nbolton/greenhouse/hardware/greenhouse-control-unit/prototype-photos/battery sensor bottom.jpg

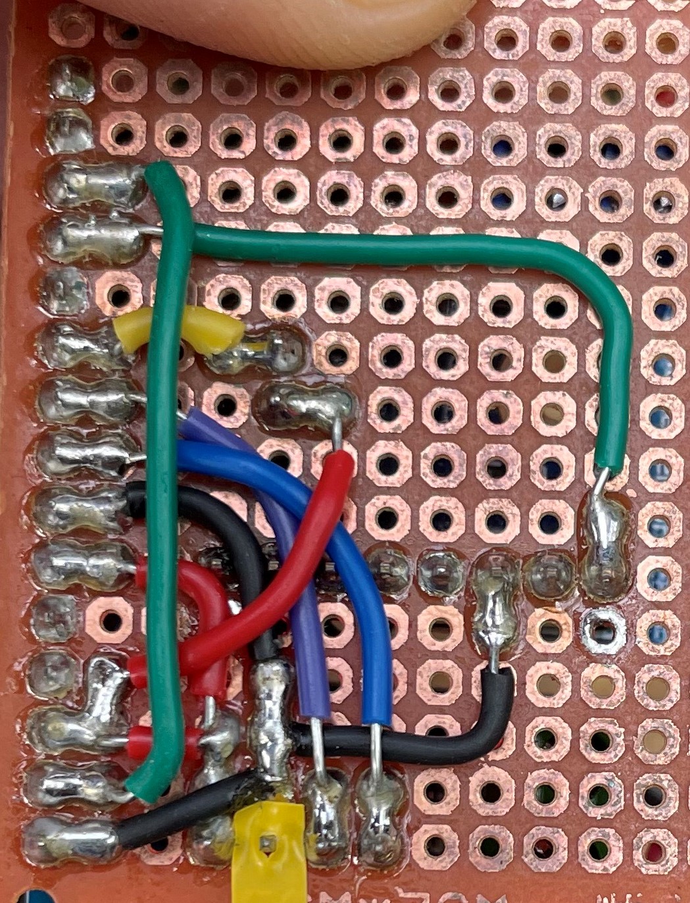
hardware/greenhouse-control-unit/prototype-photos/battery sensor bottom.jpg
