nbolton/greenhouse/hardware/greenhouse-control-unit/prototype-photos/control unit bottom.jpg

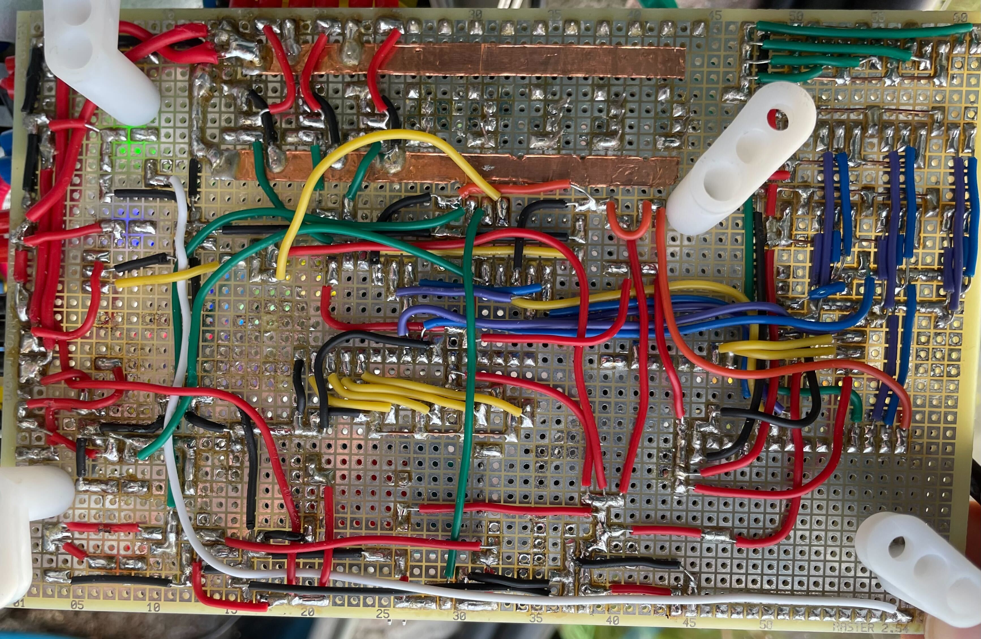
hardware/greenhouse-control-unit/prototype-photos/control unit bottom.jpg
