nbolton/greenhouse/README.md

# Greenhouse
## An attempt to automate nature 🌶

### Prerequesits
- VSCode with Platform.io extension
- MinGW if Windows
  - [Chocolatey](https://chocolatey.org/): `choco install mingw`
  - Alternative: [MinGW](https://sourceforge.net/projects/mingwbuilds/files/latest/download)
