nbolton/greenhouse/hardware/greenhouse-control-unit/prototype-photos/battery sensor top.jpg

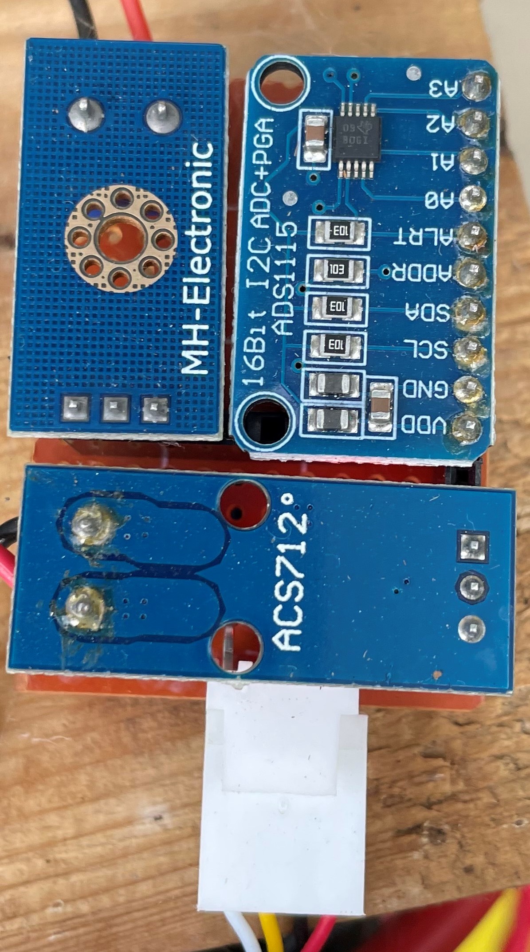
hardware/greenhouse-control-unit/prototype-photos/battery sensor top.jpg
