nbolton/greenhouse/hardware/greenhouse-control-unit/prototype-photos/battery.jpg

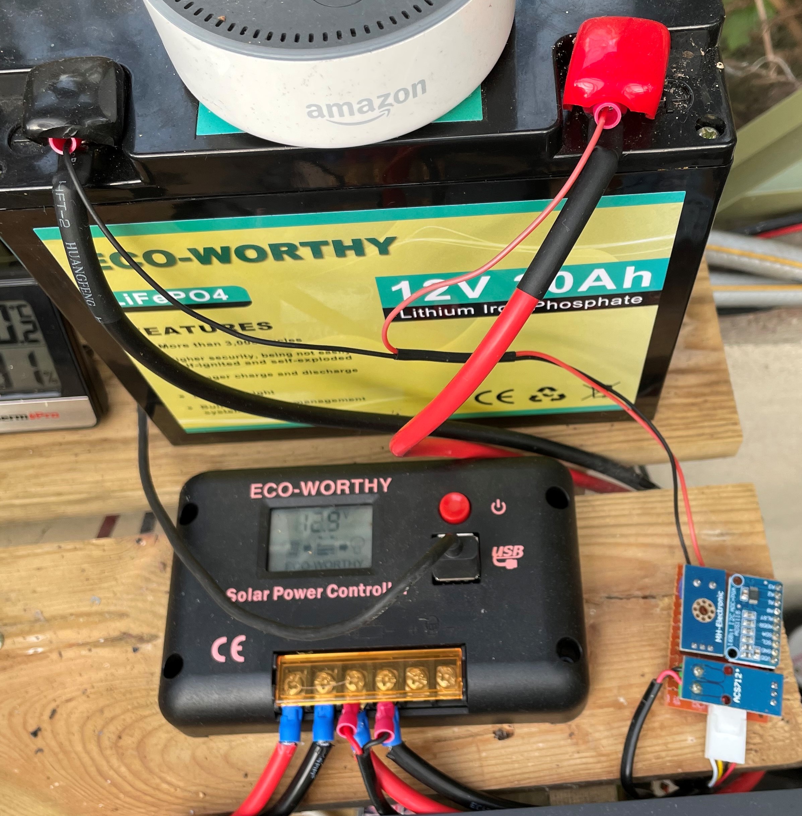
hardware/greenhouse-control-unit/prototype-photos/battery.jpg
