nbolton/greenhouse/hardware/greenhouse-control-unit/prototype-photos/control unit top.jpg

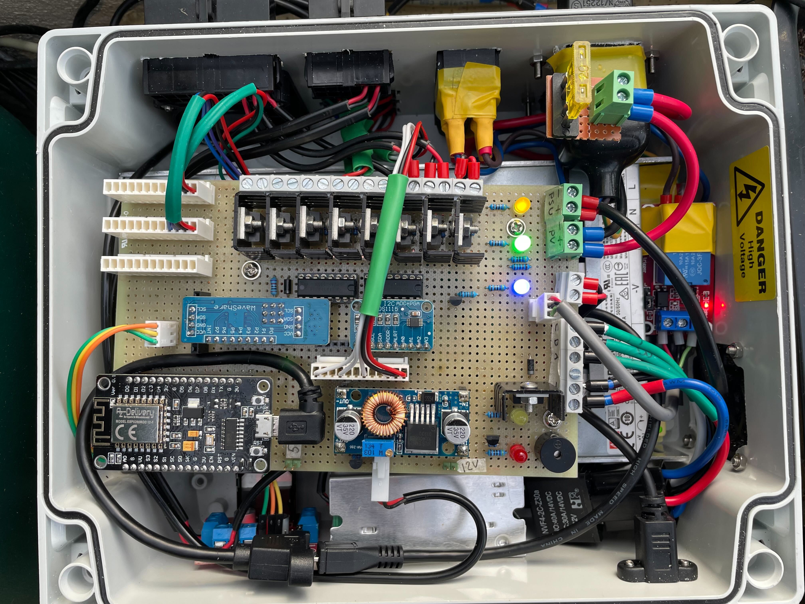
hardware/greenhouse-control-unit/prototype-photos/control unit top.jpg
