nbolton/greenhouse/hardware/greenhouse-control-unit/greenhouse-control-unit.kicad_pcb

## KiCad design hardware/greenhouse-control-unit/greenhouse-control-unit.kicad_pcb (2023-05-08)

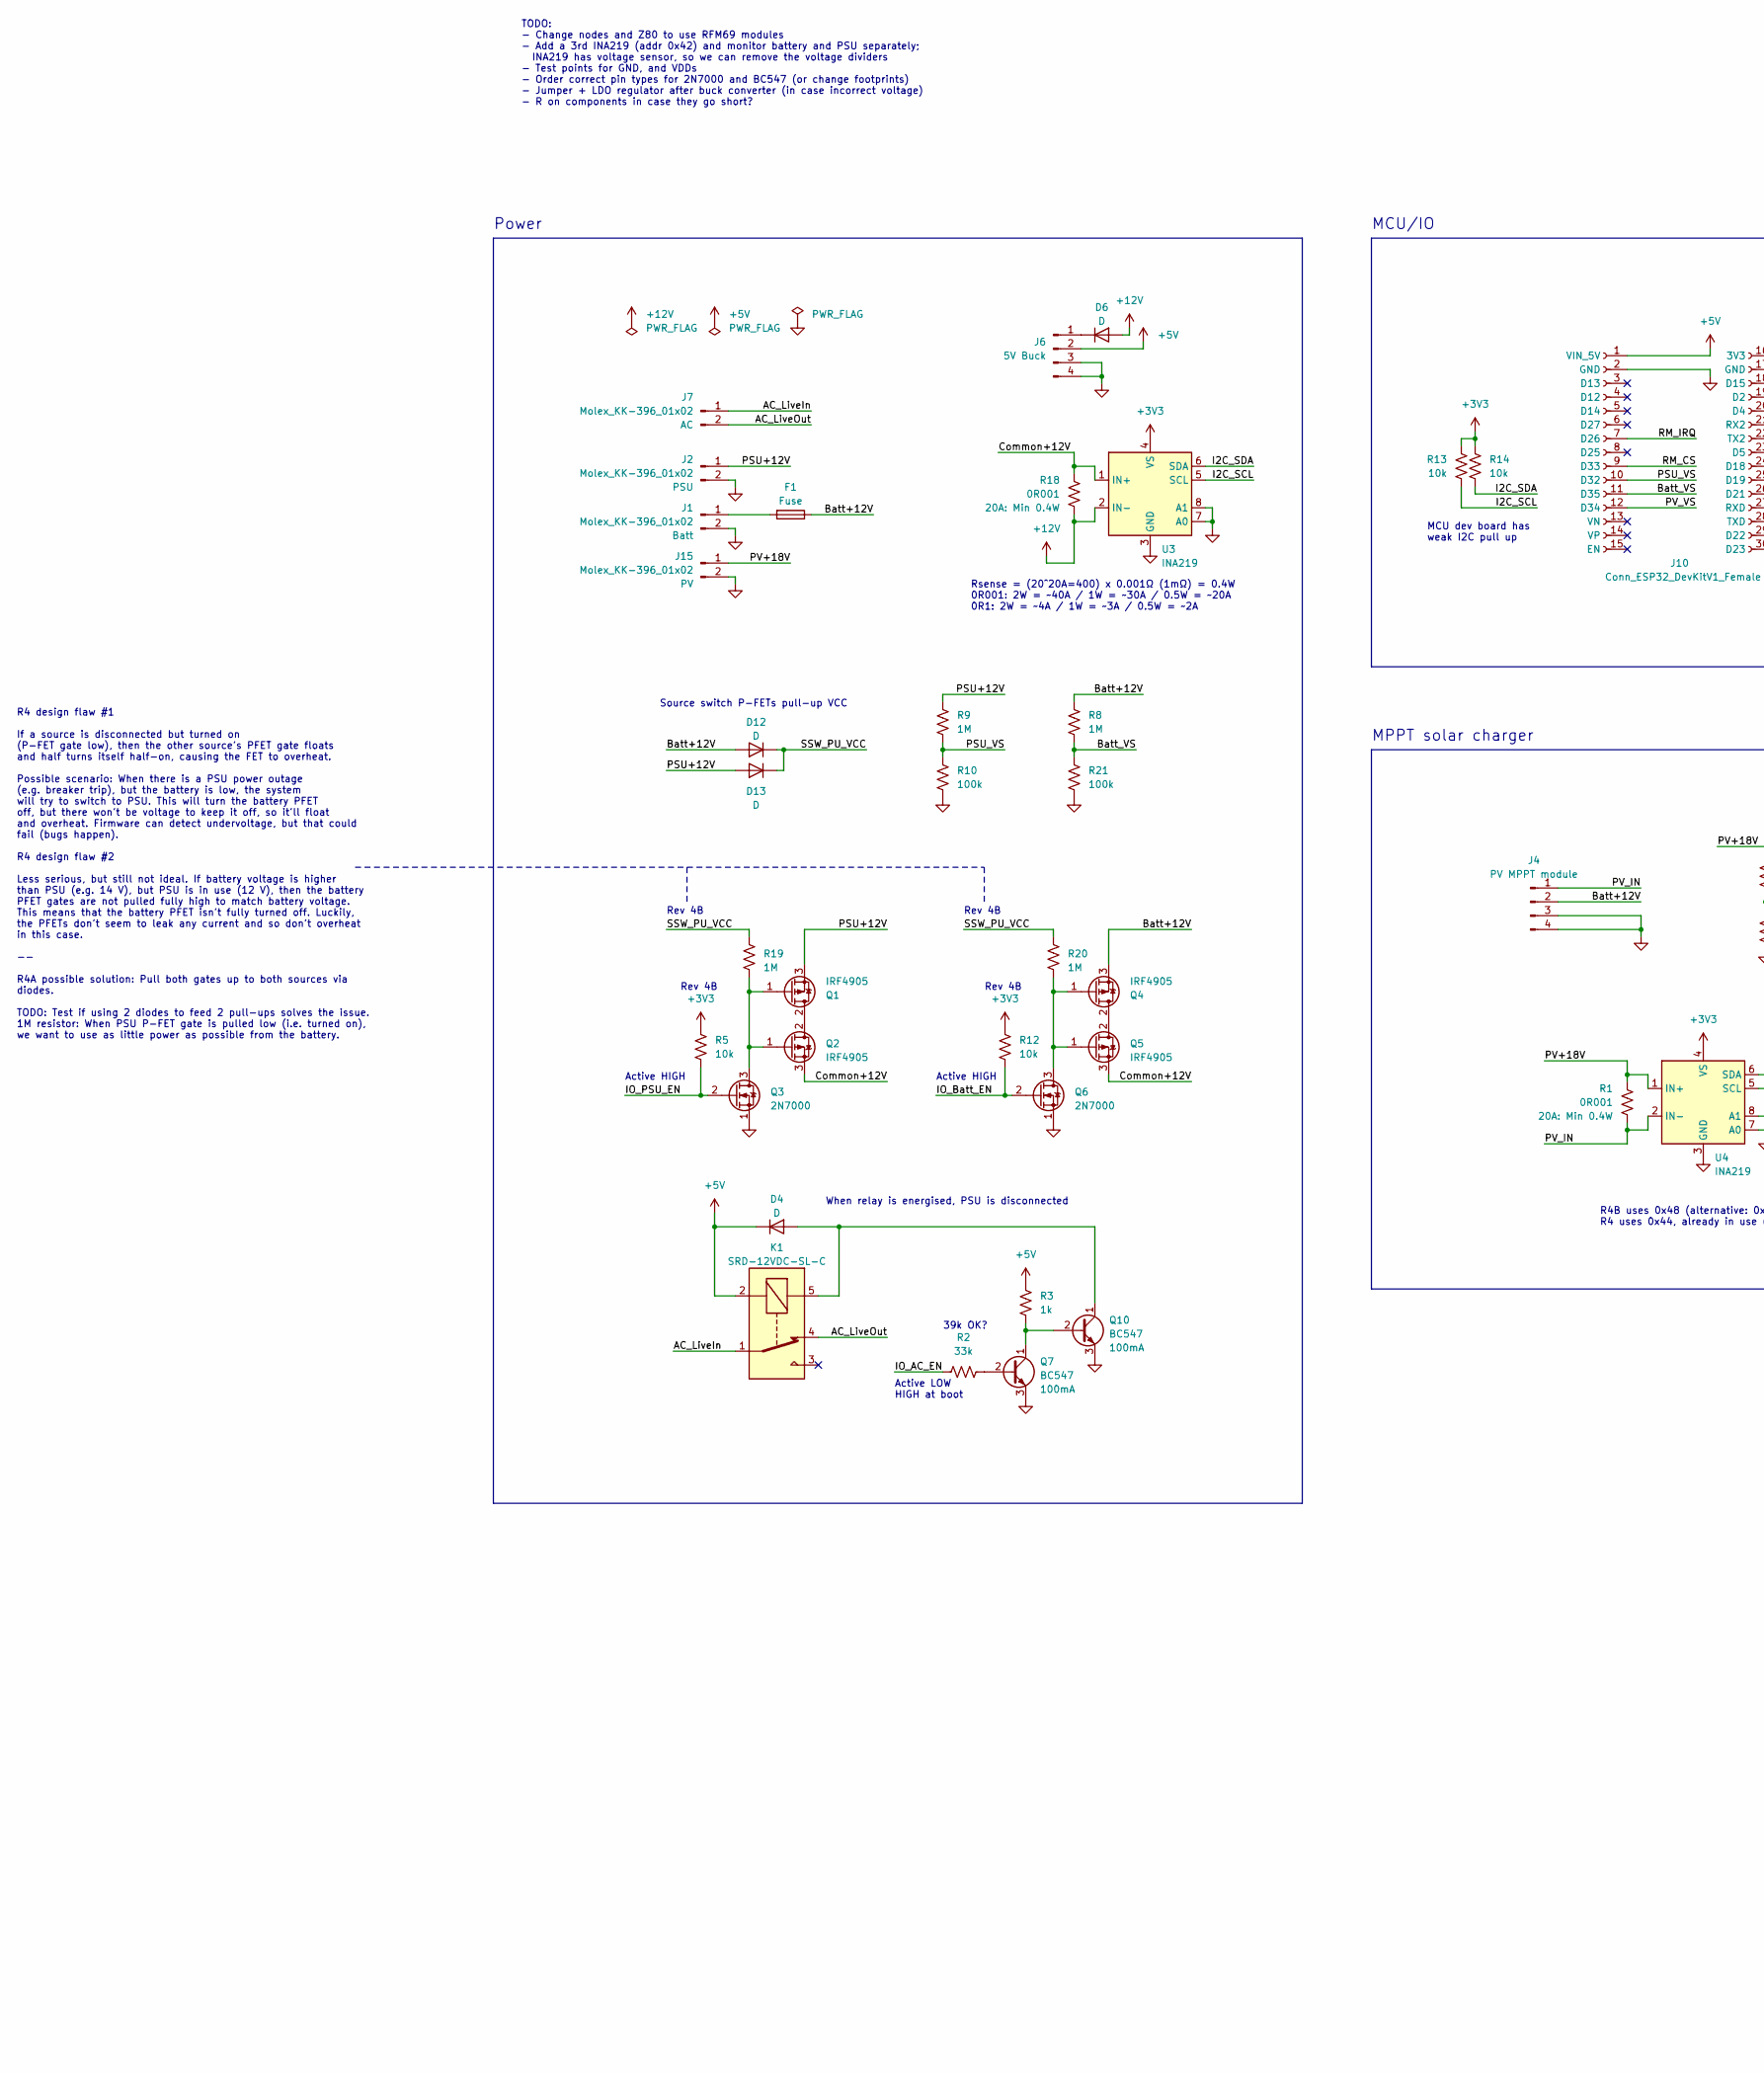
[picture p6: schematic greenhouse-control-unit.kicad_sch, Greenhouse Control Unit, part in row 1, column 1]

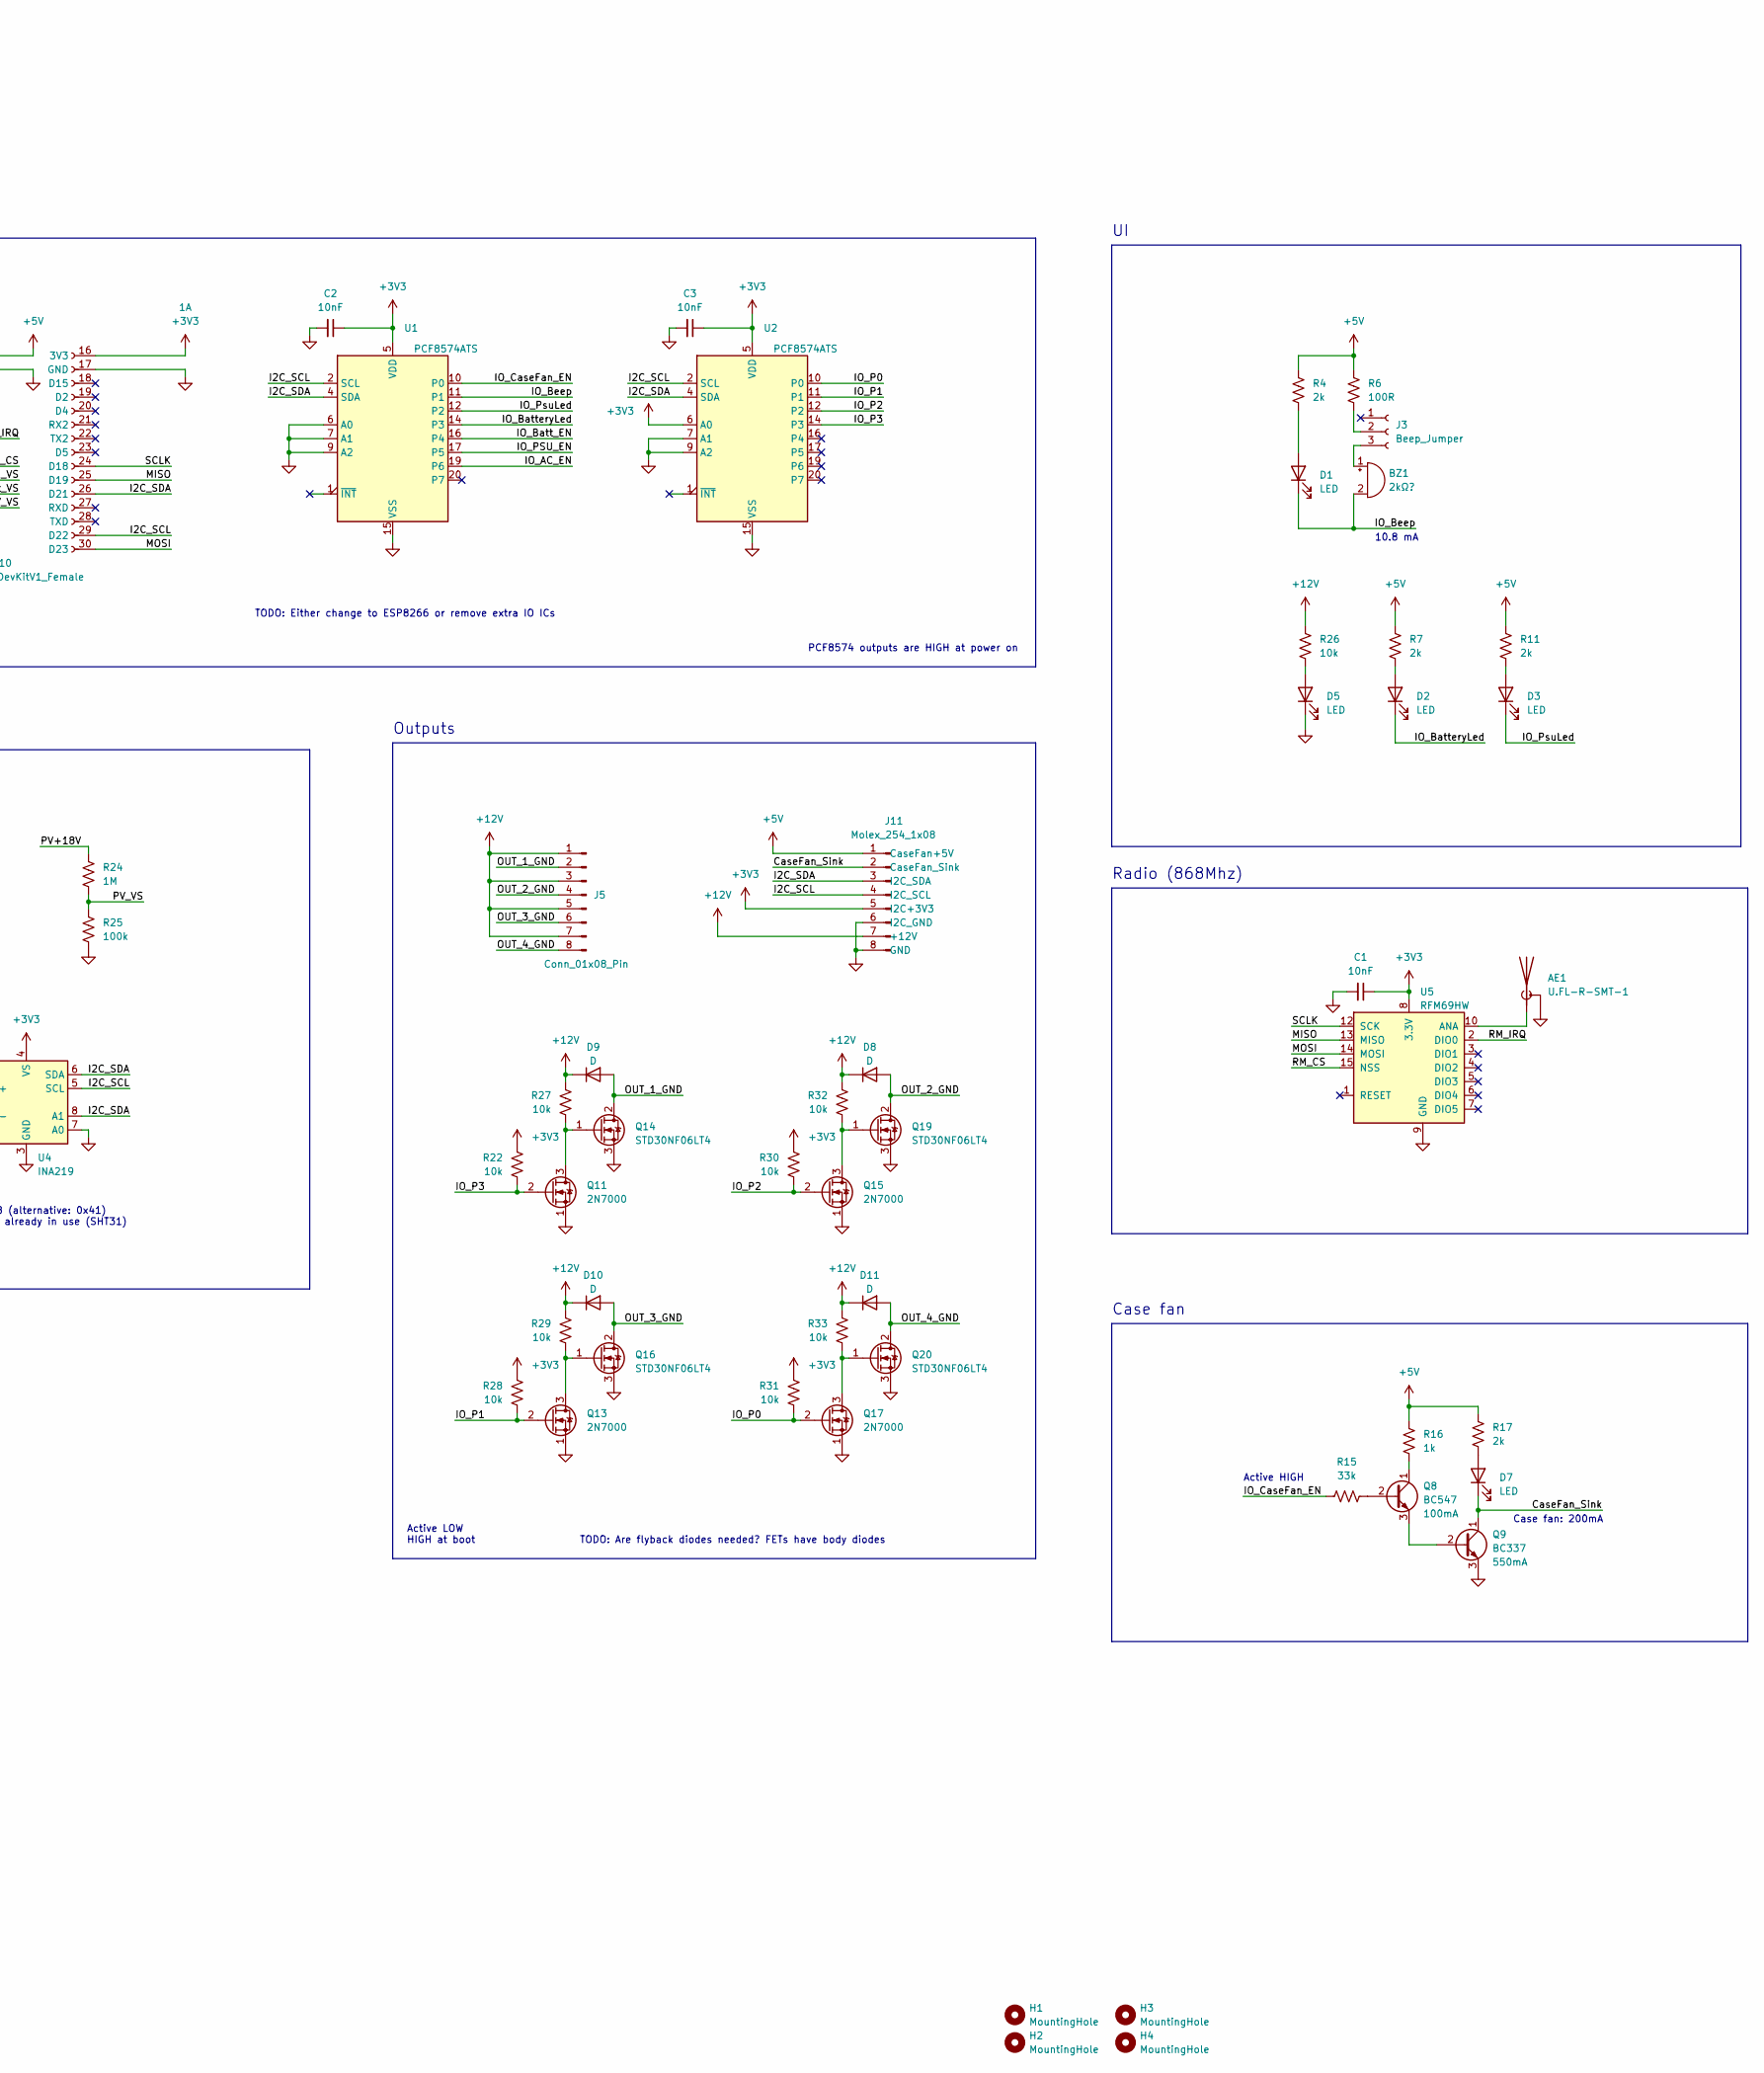
[picture p7: schematic greenhouse-control-unit.kicad_sch, Greenhouse Control Unit, part in row 1, column 2]

Parts:
AE1: U.FL-R-SMT-1; U.FL_Hirose_U.FL-R-SMT-1_Vertical
BZ1: 2kΩ?; Buzzer_12x9.5RM7.6
C1, C2, C3: 10nF; C_Disc_D3.0mm_W2.0mm_P2.50mm
D1, D2, D3, D5, D7: LED; LED_D5.0mm
D4, D12, D13: D; D_DO-35_SOD27_P7.62mm_Horizontal
D6: D; D_DO-41_SOD81_P7.62mm_Horizontal
D8, D9, D10, D11: D; D_DO-41_SOD81_P2.54mm_Vertical_AnodeUp
F1: Fuse; Fuse_3522-2_L
H1, H2, H3, H4: MountingHole; MountingHole_3mm
J1, J2, J7, J15: Molex_KK-396_01x02; Molex_KK-396_1x02_P3.96mm_Vertical
J3: Beep_Jumper; PinHeader_1x03_P2.54mm_Vertical
J4: PV MPPT module; MPPT-10A-Module
J5: Conn_01x08_Pin; Molex_KK-396_1x08_P3.96mm_Vertical
J6: 5V Buck; Buck_Module
J10: Conn_ESP32_DevKitV1_Female; PinSocket_ESP32_DevKitV1
J11: Molex_254_1x08; Molex_KK-254_AE-6410-08A_1x08_P2.54mm_Vertical
K1: SRD-12VDC-SL-C; Relay_SRD-12VDC-SL-C
Q1, Q2, Q4, Q5: IRF4905; TO-220-3_Vertical
Q3, Q6, Q11, Q13, Q15, Q17: 2N7000; TO-92_Inline
Q7, Q8, Q10: BC547; TO-92_Inline
Q9: BC337; TO-92_Inline
Q14, Q16, Q19, Q20: STD30NF06LT4; TO-252-2
R1, R18: 0R001; R_2512_6332Metric_Pad1.40x3.35mm_HandSolder
R2, R15: 33k; R_Axial_DIN0207_L6.3mm_D2.5mm_P7.62mm_Horizontal
R3, R16: 1k; R_Axial_DIN0207_L6.3mm_D2.5mm_P7.62mm_Horizontal
R4, R7, R11, R17: 2k; R_Axial_DIN0207_L6.3mm_D2.5mm_P7.62mm_Horizontal
R5, R12, R22, R26, R27, R28, R29, R30, R31, R32, R33: 10k; R_Axial_DIN0207_L6.3mm_D2.5mm_P7.62mm_Horizontal
R6: 100R; R_Axial_DIN0207_L6.3mm_D2.5mm_P7.62mm_Horizontal
R8, R9, R19, R20, R24: 1M; R_Axial_DIN0207_L6.3mm_D2.5mm_P7.62mm_Horizontal
R10, R21, R25: 100k; R_Axial_DIN0207_L6.3mm_D2.5mm_P7.62mm_Horizontal
R13, R14: 10k; R_Axial_DIN0204_L3.6mm_D1.6mm_P5.08mm_Horizontal
U1, U2: PCF8574ATS; SSOP-20_4.4x6.5mm_P0.65mm
U3, U4: INA219; SOT-23-8
U5: RFM69HW; HopeRF_RFM69HW

Connections:
+3V3: C1.1, C2.1, C3.1, J10.16 (3V3), J11.5 (I2C+3V3), R5.2, R12.2, R13.1, R14.1, R22.1, R28.1, R30.1, R31.1, U1.5 (VDD), U2.5 (VDD), U2.6 (A0), U3.4 (VS), U4.4 (VS), U5.8 (3.3V)
+5V: D4.1 (K), J6.2, J10.1 (VIN_5V), J11.1 (CaseFan+5V), K1.2, R3.2, R4.1, R6.1, R7.1, R11.1, R16.2, R17.1
+12V: D6.2 (A), D8.1 (K), D9.1 (K), D10.1 (K), D11.1 (K), J5.1, J5.3, J5.5, J5.7, J11.7 (+12V), R18.1, R26.1, R27.1, R29.1, R32.1, R33.1, U3.2 (IN-)
/AC_LiveIn: J7.1, K1.1
/AC_LiveOut: J7.2, K1.4
/Batt+12V: D12.2 (A), F1.1, J4.2, Q4.3 (S), R8.1
/Batt_VS: J10.11 (D35), R8.2, R21.1
/CaseFan_Sink: D7.1 (K), J11.2 (CaseFan_Sink), Q9.1 (C)
/Common+12V: Q2.3 (S), Q5.3 (S), R18.2, U3.1 (IN+)
/I2C_SCL: J10.29 (D22), J11.4 (I2C_SCL), R13.2, U1.2 (SCL), U2.2 (SCL), U3.5 (SCL), U4.5 (SCL)
/I2C_SDA: J10.26 (D21), J11.3 (I2C_SDA), R14.2, U1.4 (SDA), U2.4 (SDA), U3.6 (SDA), U4.6 (SDA), U4.8 (A1)
/IO_AC_EN: R2.1, U1.19 (P6)
/IO_Batt_EN: Q6.2 (G), R12.1, U1.16 (P4)
/IO_BatteryLed: D2.1 (K), U1.14 (P3)
/IO_Beep: BZ1.2 (+), D1.1 (K), U1.11 (P1)
/IO_CaseFan_EN: R15.1, U1.10 (P0)
/IO_P0: Q17.2 (G), R31.2, U2.10 (P0)
/IO_P1: Q13.2 (G), R28.2, U2.11 (P1)
/IO_P2: Q15.2 (G), R30.2, U2.12 (P2)
/IO_P3: Q11.2 (G), R22.2, U2.14 (P3)
/IO_PSU_EN: Q3.2 (G), R5.1, U1.17 (P5)
/IO_PsuLed: D3.1 (K), U1.12 (P2)
/MISO: J10.25 (D19), U5.13 (MISO)
/MOSI: J10.30 (D23), U5.14 (MOSI)
/OUT_1_GND: D9.2 (A), J5.2, Q14.2 (D)
/OUT_2_GND: D8.2 (A), J5.4, Q19.2 (D)
/OUT_3_GND: D10.2 (A), J5.6, Q16.2 (D)
/OUT_4_GND: D11.2 (A), J5.8, Q20.2 (D)
/PSU+12V: D13.2 (A), J2.1, Q1.3 (S), R9.1
/PSU_VS: J10.10 (D32), R9.2, R10.1
/PV+18V: J15.1, R1.2, R24.1, U4.1 (IN+)
/PV_IN: J4.1, R1.1, U4.2 (IN-)
/PV_VS: J10.12 (D34), R24.2, R25.1
/RM_CS: J10.9 (D33), U5.15 (NSS)
/RM_IRQ: J10.7 (D26), U5.2 (DIO0)
/SCLK: J10.24 (D18), U5.12 (SCK)
/SSW_PU_VCC: D12.1 (K), D13.1 (K), R19.2, R20.2
GND: AE1.2 (Shield), C1.2, C2.2, C3.2, D5.1 (K), J1.2, J2.2, J4.3, J4.4, J6.3, J6.4, J10.2 (GND), J10.17 (GND), J11.6 (I2C_GND), J11.8 (GND), J15.2, Q3.1 (S), Q6.1 (S), Q7.3 (E), Q9.3 (E), Q10.3 (E), Q11.1 (S), Q13.1 (S), Q14.3 (S), Q15.1 (S), Q16.3 (S), Q17.1 (S), Q19.3 (S), Q20.3 (S), R10.2, R21.2, R25.2, U1.6 (A0), U1.7 (A1), U1.9 (A2), U1.15 (VSS), U2.7 (A1), U2.9 (A2), U2.15 (VSS), U3.3 (GND), U3.7 (A0), U3.8 (A1), U4.3 (GND), U4.7 (A0), U5.9 (GND), U5.11 (GND)
unnamed: AE1.1 (A), U5.10 (ANA)
unnamed: BZ1.1 (-), J3.3
unnamed: D1.2 (A), R4.2
unnamed: D2.2 (A), R7.2
unnamed: D3.2 (A), R11.2
unnamed: D4.2 (A), K1.5, Q10.1 (C)
unnamed: D5.2 (A), R26.2
unnamed: D6.1 (K), J6.1
unnamed: D7.2 (A), R17.2
unnamed: F1.2, J1.1
unnamed: J3.2, R6.2
unnamed: Q1.2 (D), Q2.2 (D)
unnamed: Q1.1 (G), Q2.1 (G), Q3.3 (D), R19.1
unnamed: Q4.2 (D), Q5.2 (D)
unnamed: Q4.1 (G), Q5.1 (G), Q6.3 (D), R20.1
unnamed: Q7.2 (B), R2.2
unnamed: Q8.2 (B), R15.2
unnamed: Q8.1 (C), R16.1
unnamed: Q8.3 (E), Q9.2 (B)
unnamed: Q7.1 (C), Q10.2 (B), R3.1
unnamed: Q11.3 (D), Q14.1 (G), R27.2
unnamed: Q13.3 (D), Q16.1 (G), R29.2
unnamed: Q15.3 (D), Q19.1 (G), R32.2
unnamed: Q17.3 (D), Q20.1 (G), R33.2

Notes on the sheet:
Source switch P-FETs pull-up VCC
When relay is energised, PSU is disconnected
R4B uses 0x48 (alternative: 0x41) R4 uses 0x44, already in use (SHT31)
Rsense = (20^20A=400) x 0.001Ω (1mΩ) = 0.4W 0R001: 2W = ~40A / 1W = ~30A / 0.5W = ~20A 0R1: 2W = ~4A / 1W = ~3A / 0.5W = ~2A
R4 design flaw #1 If a source is disconnected but turned on (P-FET gate low), then the other source's PFET gate floats and half turns itself half-on, causing the FET to overheat. Possible scenario: When there is a PSU power outage (e.g. breaker trip), but the battery is low, the system will try to 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
TODO: - Change nodes and Z80 to use RFM69 modules - Add a 3rd INA219 (addr 0x42) and monitor battery and PSU separately; INA219 has voltage sensor, so we can remove the voltage dividers - Test points for GND, and VDDs - Order correct pin types for 2N7000 and BC547 (or change footprints) - Jumper + 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
Rev 4B
MCU/IO
TODO: Either change to ESP8266 or remove extra IO ICs
Active HIGH
Active LOW HIGH at boot
Case fan: 200mA
Power
Radio (868Mhz)
Outputs
10.8 mA
MCU dev board has weak I2C pull up
TODO: Are flyback diodes needed? FETs have body diodes
PCF8574 outputs are HIGH at power on
39k OK?
Case fan
MPPT solar charger

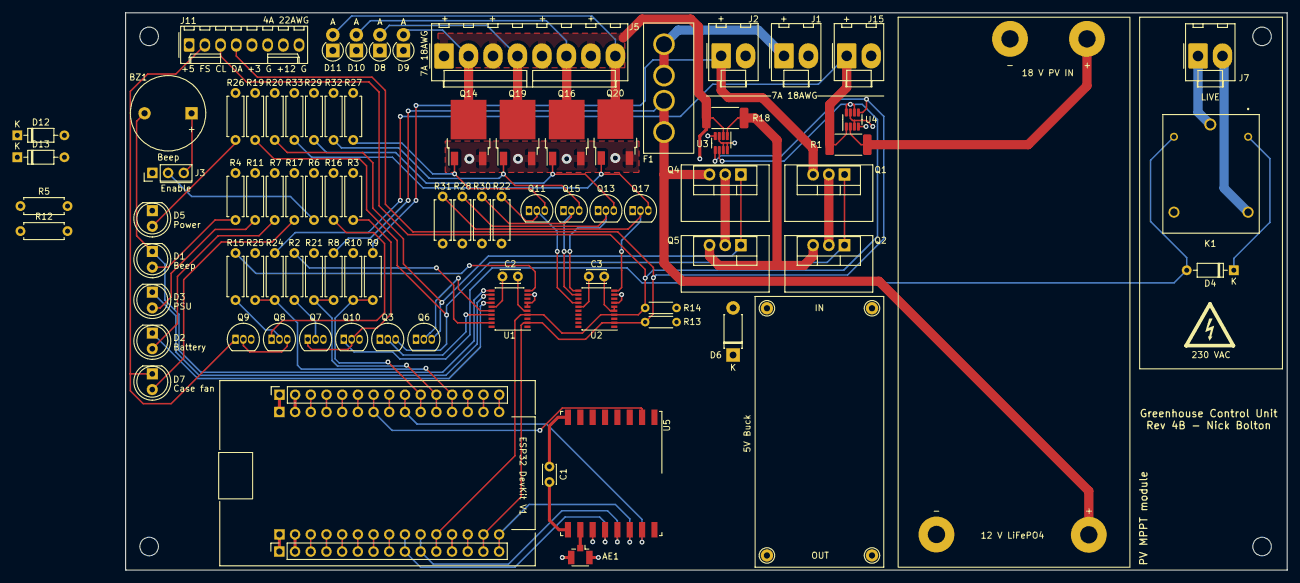
[picture p8: board greenhouse-control-unit.kicad_pcb from above]

Board: 4 copper layers, 188.0 x 90.2 mm, 89 parts (0 on the bottom side), 62 nets.
