nbolton/greenhouse/hardware/greenhouse-node-ts/greenhouse-node-ts.kicad_pcb

## KiCad design hardware/greenhouse-node-ts/greenhouse-node-ts.kicad_pcb (2023-04-27)

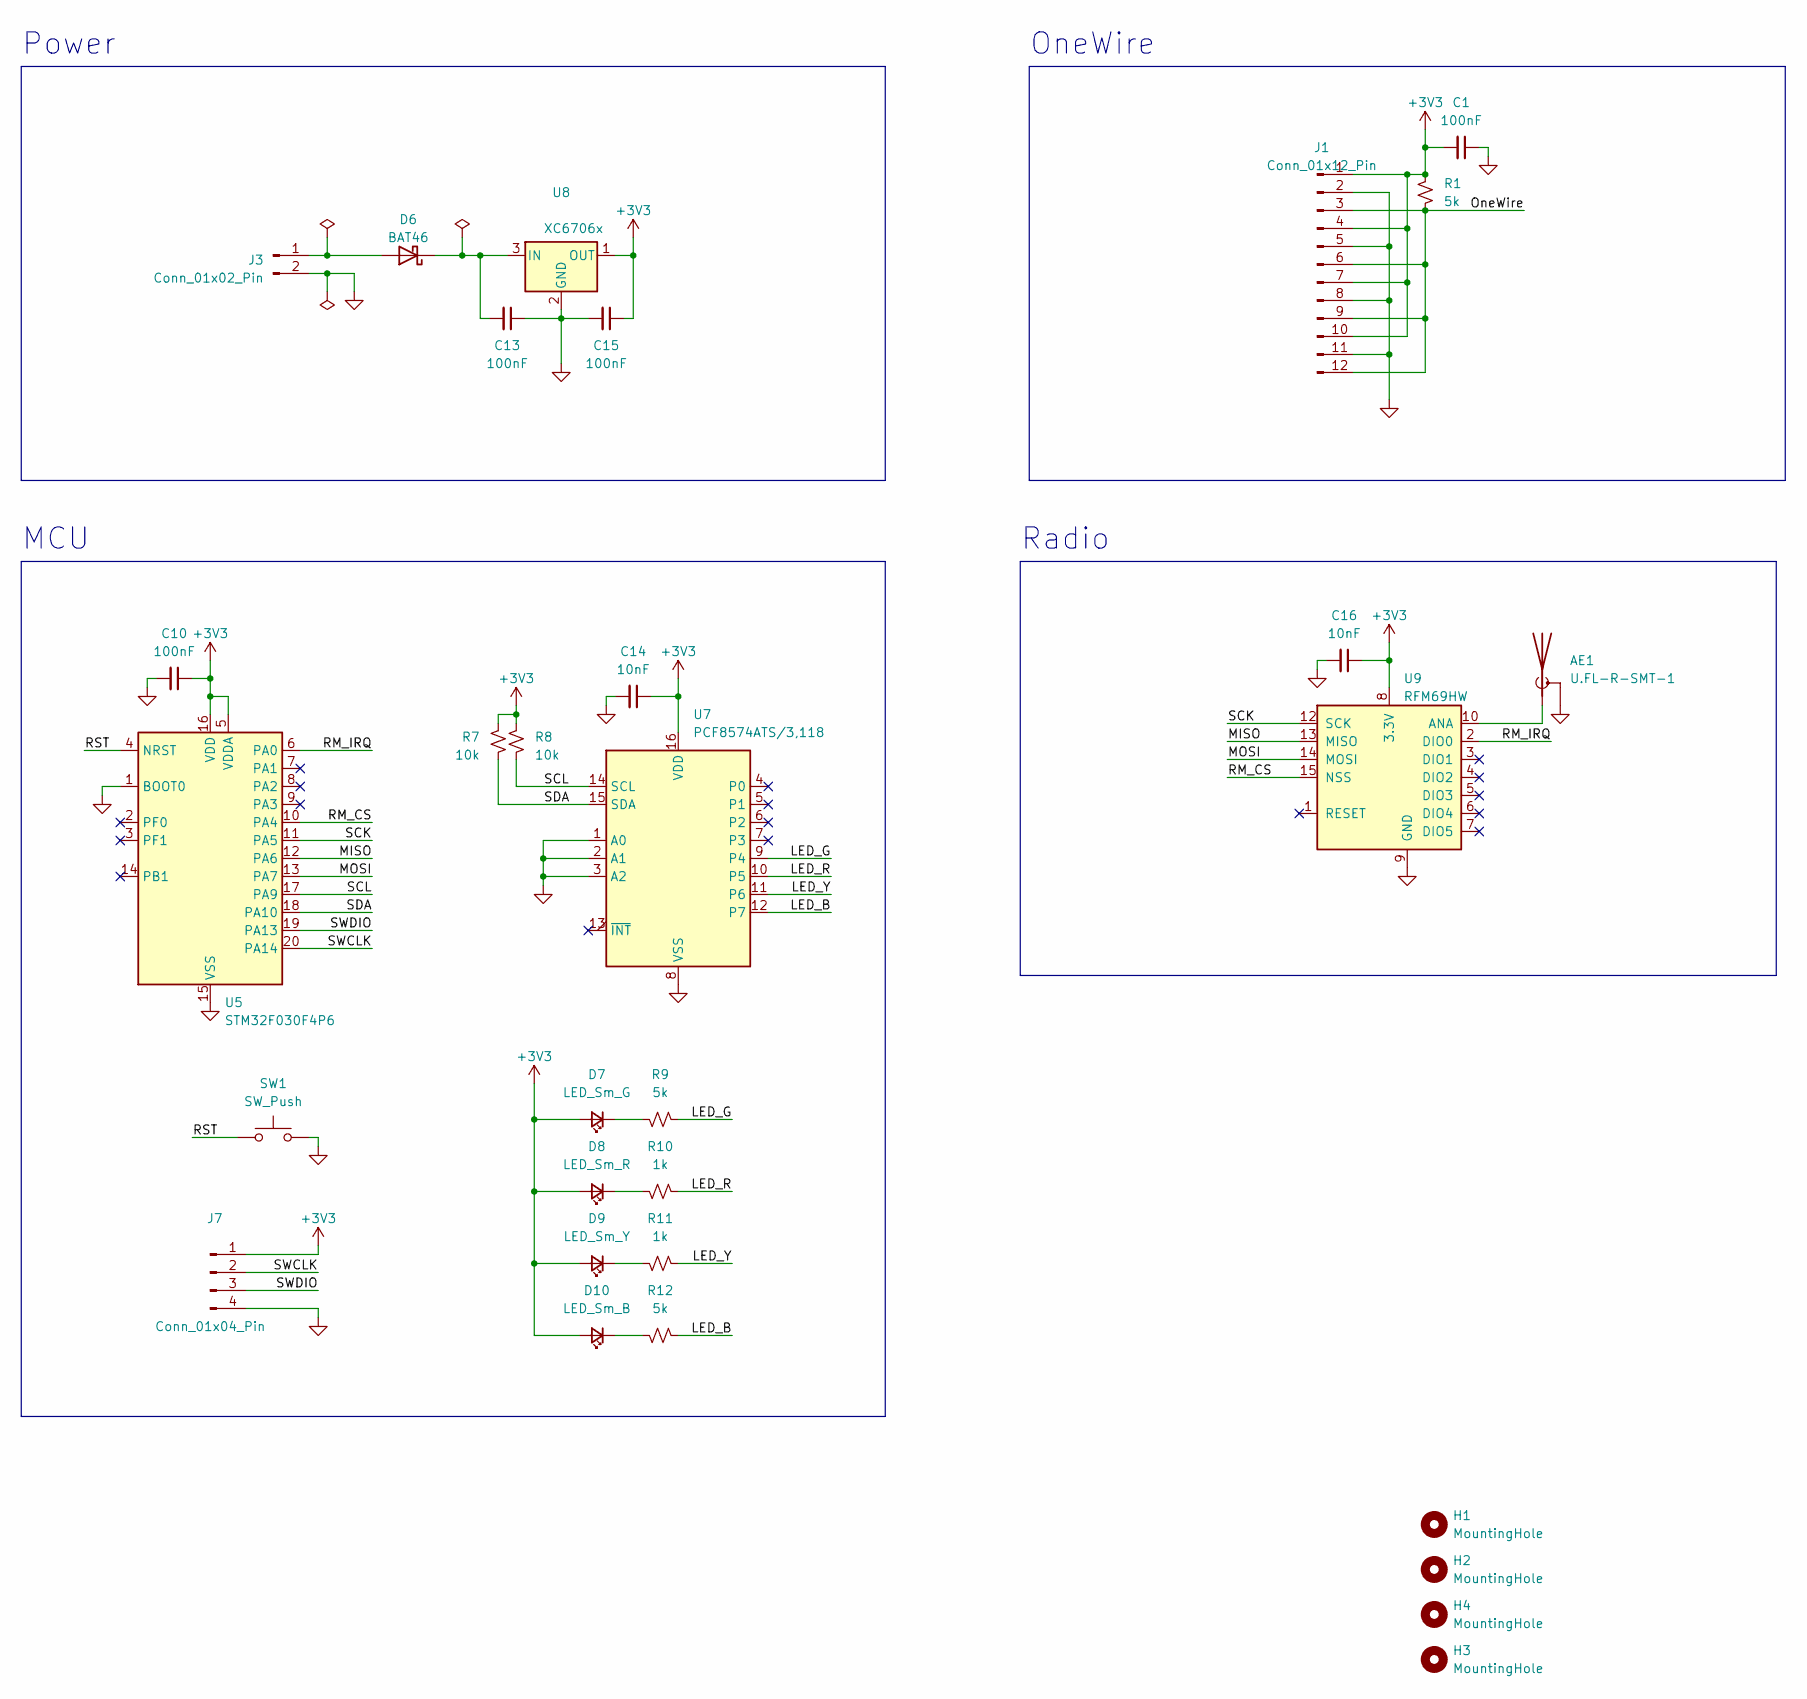
[picture p9: schematic greenhouse-node-ts.kicad_sch, Greenhouse Node (TS)]

Parts:
AE1: U.FL-R-SMT-1; U.FL_Hirose_U.FL-R-SMT-1_Vertical
C1, C10, C13, C15: 100nF; C_Disc_D4.7mm_W2.5mm_P5.00mm
C14, C16: 10nF; C_Disc_D3.0mm_W2.0mm_P2.50mm
D6: BAT46; D_DO-35_SOD27_P7.62mm_Horizontal
D7: LED_Sm_G; LED_D3.0mm
D8: LED_Sm_R; LED_D3.0mm
D9: LED_Sm_Y; LED_D3.0mm
D10: LED_Sm_B; LED_D3.0mm
H1, H2, H3, H4: MountingHole; MountingHole_3.2mm_M3
J1: Conn_01x12_Pin
J3: Conn_01x02_Pin; Molex_KK-254_AE-6410-02A_1x02_P2.54mm_Vertical
J7: Conn_01x04_Pin; JST_PH_B4B-PH-K_1x04_P2.00mm_Vertical
R1, R9, R12: 5k; R_Axial_DIN0207_L6.3mm_D2.5mm_P7.62mm_Horizontal
R7, R8: 10k; R_Axial_DIN0207_L6.3mm_D2.5mm_P7.62mm_Horizontal
R10, R11: 1k; R_Axial_DIN0207_L6.3mm_D2.5mm_P7.62mm_Horizontal
SW1: SW_Push; SW_PUSH_6mm
U5: STM32F030F4P6; TSSOP-20_4.4x6.5mm_P0.65mm
U7: PCF8574ATS/3,118; SSOP-20_4.4x6.5mm_P0.65mm
U8: XC6706x; SOT-89-3
U9: RFM69HW; HopeRF_RFM69HW

Connections:
+3V3: C1.2, C10.1, C14.1, C15.1, C16.1, D7.2 (A), D8.2 (A), D9.2 (A), D10.2 (A), J1.1, J1.4, J1.7, J1.10, J7.1, R1.1, R7.1, R8.1, U5.5 (VDDA), U5.16 (VDD), U7.16 (VDD), U8.1 (OUT), U9.8 (3.3V)
/LED_B: R12.1, U7.12 (P7)
/LED_G: R9.1, U7.9 (P4)
/LED_R: R10.1, U7.10 (P5)
/LED_Y: R11.1, U7.11 (P6)
/MISO: U5.12 (PA6), U9.13 (MISO)
/MOSI: U5.13 (PA7), U9.14 (MOSI)
/OneWire: J1.3, J1.6, J1.9, J1.12, R1.2
/RM_CS: U5.10 (PA4), U9.15 (NSS)
/RM_IRQ: U5.6 (PA0), U9.2 (DIO0)
/RST: SW1.1, U5.4 (NRST)
/SCK: U5.11 (PA5), U9.12 (SCK)
/SCL: R8.2, U5.17 (PA9), U7.14 (SCL)
/SDA: R7.2, U5.18 (PA10), U7.15 (SDA)
/SWCLK: J7.2, U5.20 (PA14)
/SWDIO: J7.3, U5.19 (PA13)
GND: AE1.2 (Shield), C1.1, C10.2, C13.1, C14.2, C15.2, C16.2, J1.2, J1.5, J1.8, J1.11, J3.2, J7.4, SW1.2, U5.1 (BOOT0), U5.15 (VSS), U7.1 (A0), U7.2 (A1), U7.3 (A2), U7.8 (VSS), U8.2 (GND), U9.9 (GND), U9.11 (GND)
unnamed: D6.2 (A), J3.1
unnamed: C13.2, D6.1 (K), U8.3 (IN)
unnamed: AE1.1 (A), U9.10 (ANA)
unnamed: D7.1 (K), R9.2
unnamed: D8.1 (K), R10.2
unnamed: D9.1 (K), R11.2
unnamed: D10.1 (K), R12.2

Notes on the sheet:
Power
MCU
OneWire
Radio

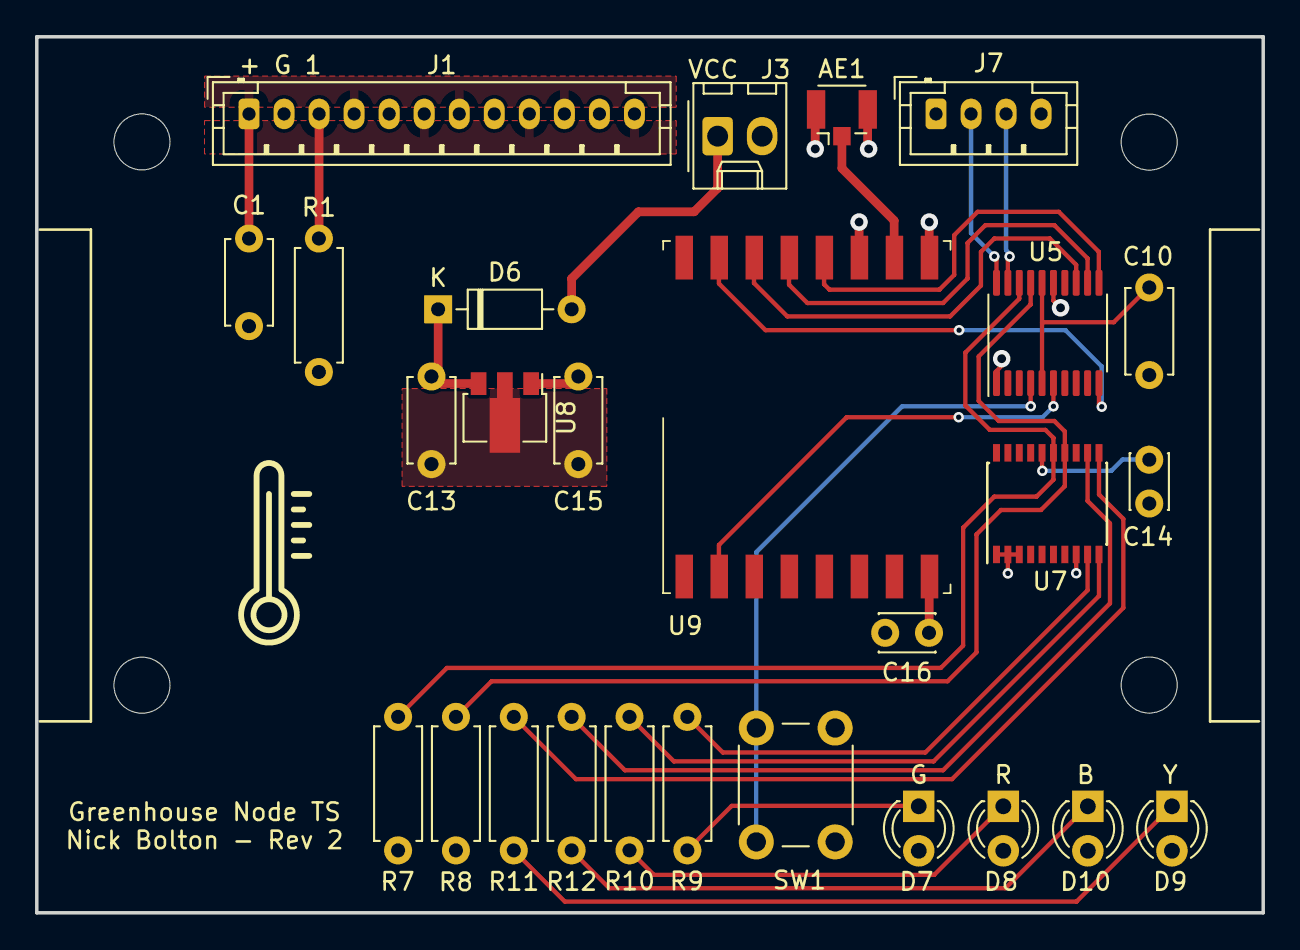
[picture p10: board greenhouse-node-ts.kicad_pcb from above]

Board: 4 copper layers, 70.0 x 50.0 mm, 31 parts (0 on the bottom side), 24 nets.
