nbolton/greenhouse/hardware/greenhouse-node-hb/greenhouse-node-hb.kicad_pcb

## KiCad design hardware/greenhouse-node-hb/greenhouse-node-hb.kicad_pcb (2023-04-27)

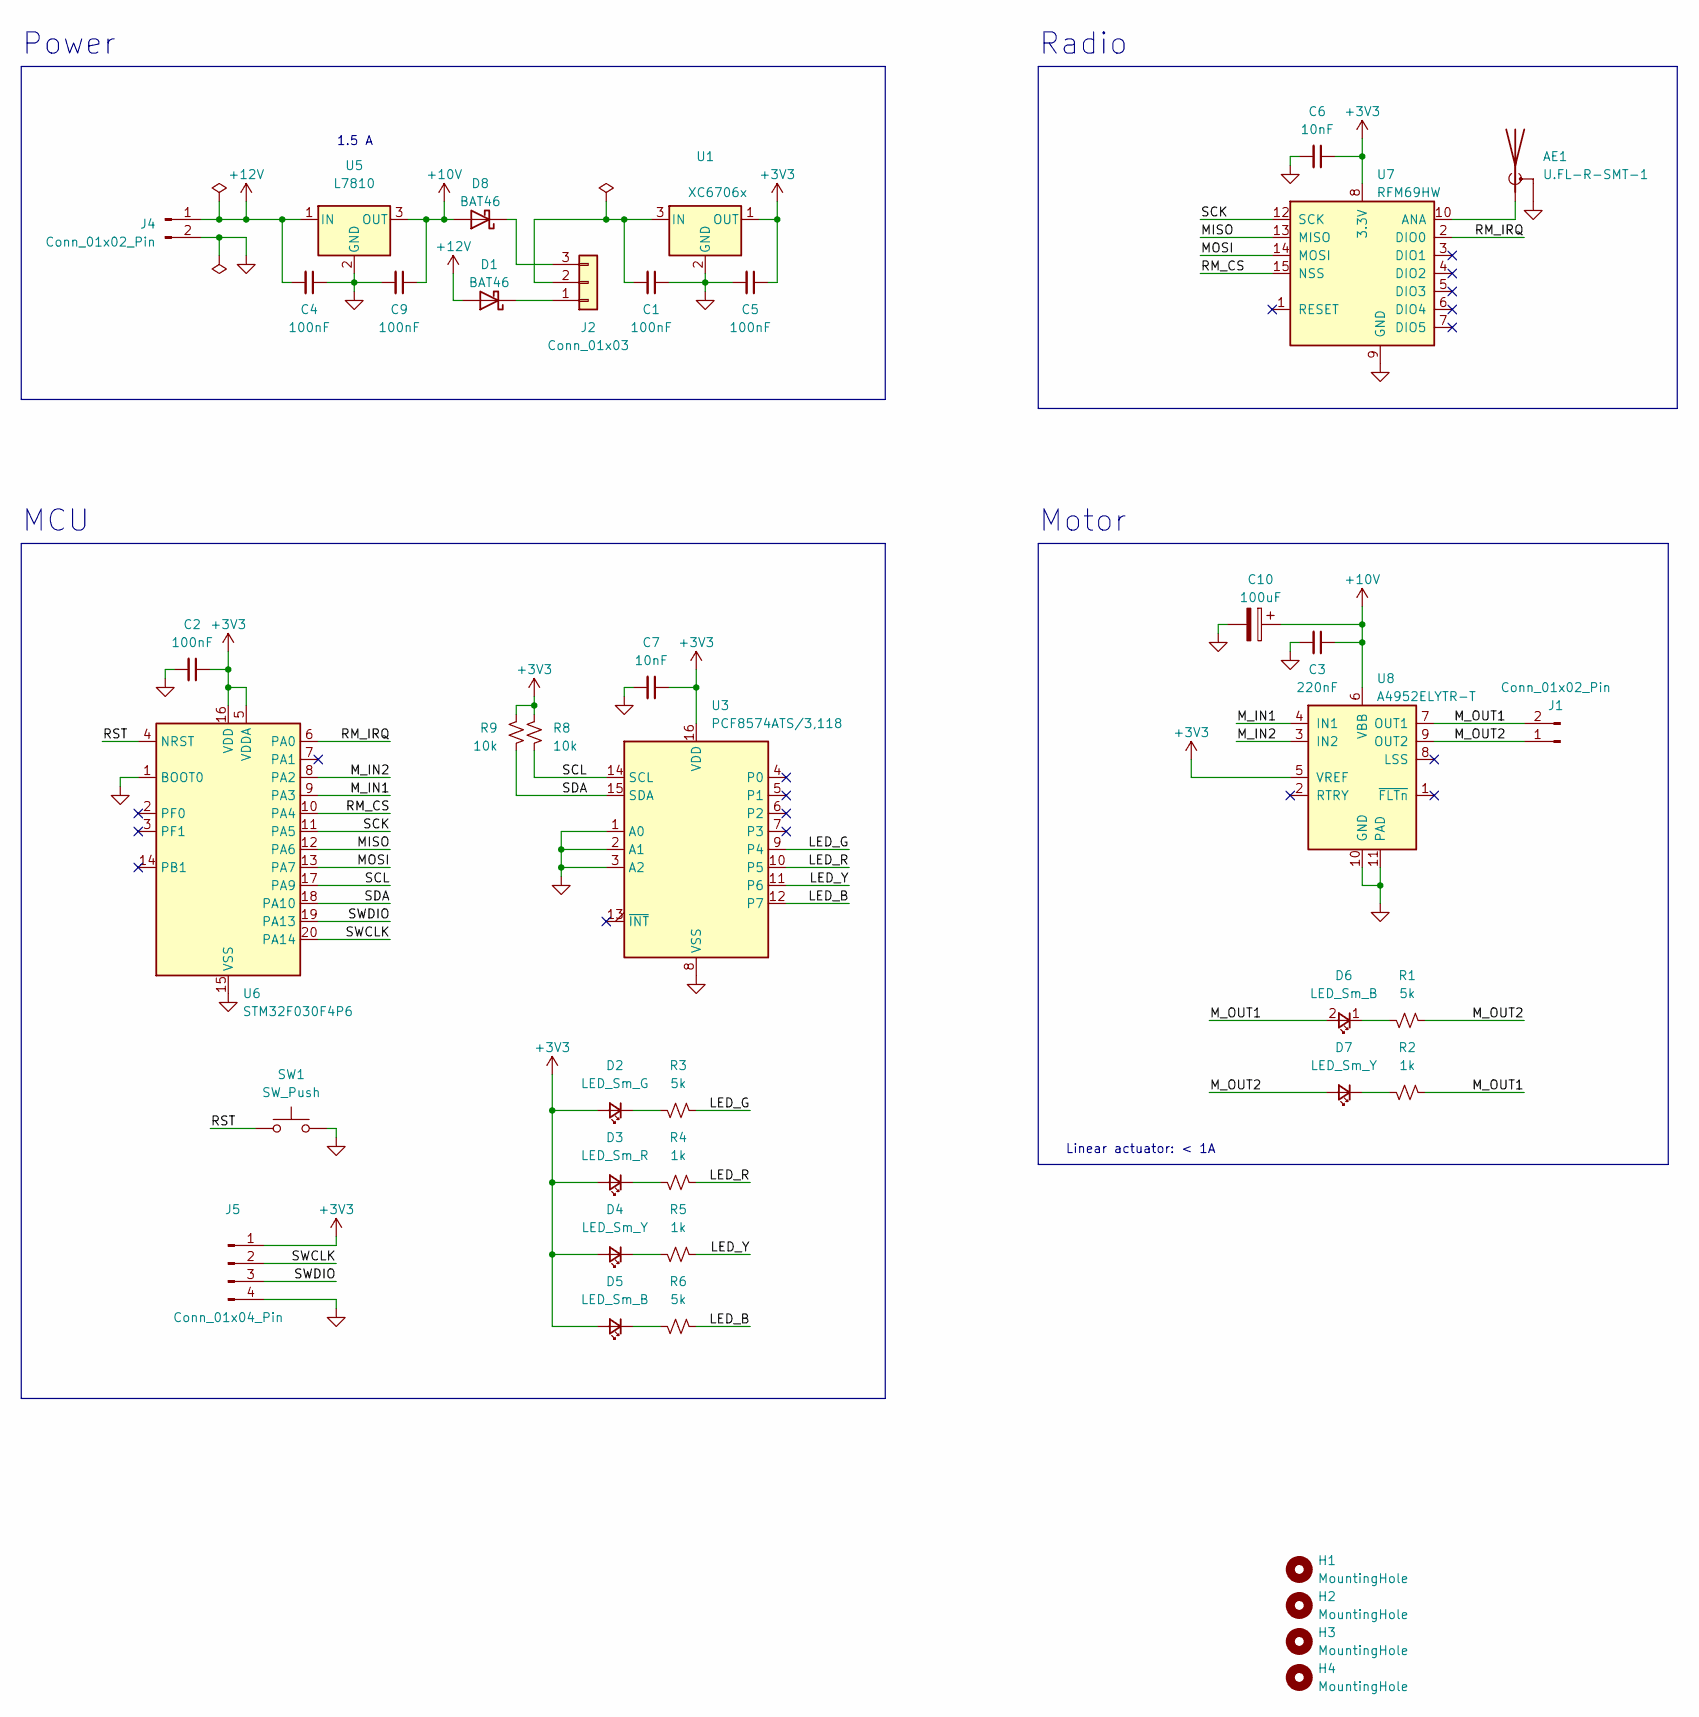
[picture p11: schematic greenhouse-node-hb.kicad_sch, Greenhouse Node HB (Mini)]

Parts:
AE1: U.FL-R-SMT-1; U.FL_Hirose_U.FL-R-SMT-1_Vertical
C1, C2, C4, C5, C9: 100nF; C_Disc_D4.7mm_W2.5mm_P5.00mm
C3: 220nF; C_Disc_D4.7mm_W2.5mm_P5.00mm
C6, C7: 10nF; C_Disc_D3.0mm_W2.0mm_P2.50mm
C10: 100uF; CP_Radial_D6.3mm_P2.50mm
D1, D8: BAT46; D_DO-35_SOD27_P7.62mm_Horizontal
D2: LED_Sm_G; LED_D3.0mm
D3: LED_Sm_R; LED_D3.0mm
D4, D7: LED_Sm_Y; LED_D3.0mm
D5, D6: LED_Sm_B; LED_D3.0mm
H1, H2, H3, H4: MountingHole; MountingHole_3.2mm_M3
J1, J4: Conn_01x02_Pin; Molex_KK-254_AE-6410-02A_1x02_P2.54mm_Vertical
J2: Conn_01x03; SolderJumper-3_P1.3mm_Bridged2Bar12_RoundedPad1.0x1.5mm
J5: Conn_01x04_Pin; JST_PH_B4B-PH-K_1x04_P2.00mm_Vertical
R1, R3, R6: 5k; R_Axial_DIN0207_L6.3mm_D2.5mm_P7.62mm_Horizontal
R2, R4, R5: 1k; R_Axial_DIN0207_L6.3mm_D2.5mm_P7.62mm_Horizontal
R8, R9: 10k; R_Axial_DIN0207_L6.3mm_D2.5mm_P7.62mm_Horizontal
SW1: SW_Push; SW_PUSH_6mm
U1: XC6706x; SOT-89-3
U3: PCF8574ATS/3,118; SSOP-20_4.4x6.5mm_P0.65mm
U5: L7810; TO-220-3_Horizontal_TabUp
U6: STM32F030F4P6; TSSOP-20_4.4x6.5mm_P0.65mm
U7: RFM69HW; HopeRF_RFM69HW
U8: A4952ELYTR-T; MSOP-10-1EP_3x3mm_P0.5mm_EP1.73x1.98mm

Connections:
+3V3: C2.1, C5.1, C6.1, C7.1, D2.2 (A), D3.2 (A), D4.2 (A), D5.2 (A), J5.1, R8.1, R9.1, U1.1 (OUT), U3.16 (VDD), U6.5 (VDDA), U6.16 (VDD), U7.8 (3.3V), U8.5 (VREF)
+10V: C3.1, C9.1, C10.1, D8.2 (A), U5.3 (OUT), U8.6 (VBB)
+12V: C4.2, D1.2 (A), J4.1, U5.1 (IN)
/LED_B: R6.1, U3.12 (P7)
/LED_G: R3.1, U3.9 (P4)
/LED_R: R4.1, U3.10 (P5)
/LED_Y: R5.1, U3.11 (P6)
/MISO: U6.12 (PA6), U7.13 (MISO)
/MOSI: U6.13 (PA7), U7.14 (MOSI)
/M_IN1: U6.9 (PA3), U8.4 (IN1)
/M_IN2: U6.8 (PA2), U8.3 (IN2)
/M_OUT1: D6.2 (A), J1.2, R2.1, U8.7 (OUT1)
/M_OUT2: D7.2 (A), J1.1, R1.1, U8.9 (OUT2)
/RM_CS: U6.10 (PA4), U7.15 (NSS)
/RM_IRQ: U6.6 (PA0), U7.2 (DIO0)
/RST: SW1.1, U6.4 (NRST)
/SCK: U6.11 (PA5), U7.12 (SCK)
/SCL: R8.2, U3.14 (SCL), U6.17 (PA9)
/SDA: R9.2, U3.15 (SDA), U6.18 (PA10)
/SWCLK: J5.2, U6.20 (PA14)
/SWDIO: J5.3, U6.19 (PA13)
GND: AE1.2 (Shield), C1.1, C2.2, C3.2, C4.1, C5.2, C6.2, C7.2, C9.2, C10.2, J4.2, J5.4, SW1.2, U1.2 (GND), U3.1 (A0), U3.2 (A1), U3.3 (A2), U3.8 (VSS), U5.2 (GND), U6.1 (BOOT0), U6.15 (VSS), U7.9 (GND), U7.11 (GND), U8.10 (GND), U8.11 (PAD)
unnamed: C1.2, J2.2, U1.3 (IN)
unnamed: AE1.1 (A), U7.10 (ANA)
unnamed: D1.1 (K), J2.1
unnamed: D2.1 (K), R3.2
unnamed: D3.1 (K), R4.2
unnamed: D4.1 (K), R5.2
unnamed: D5.1 (K), R6.2
unnamed: D6.1 (K), R1.2
unnamed: D7.1 (K), R2.2
unnamed: D8.1 (K), J2.3

Notes on the sheet:
Motor
MCU
Linear actuator: < 1A
Power
1.5 A
Radio

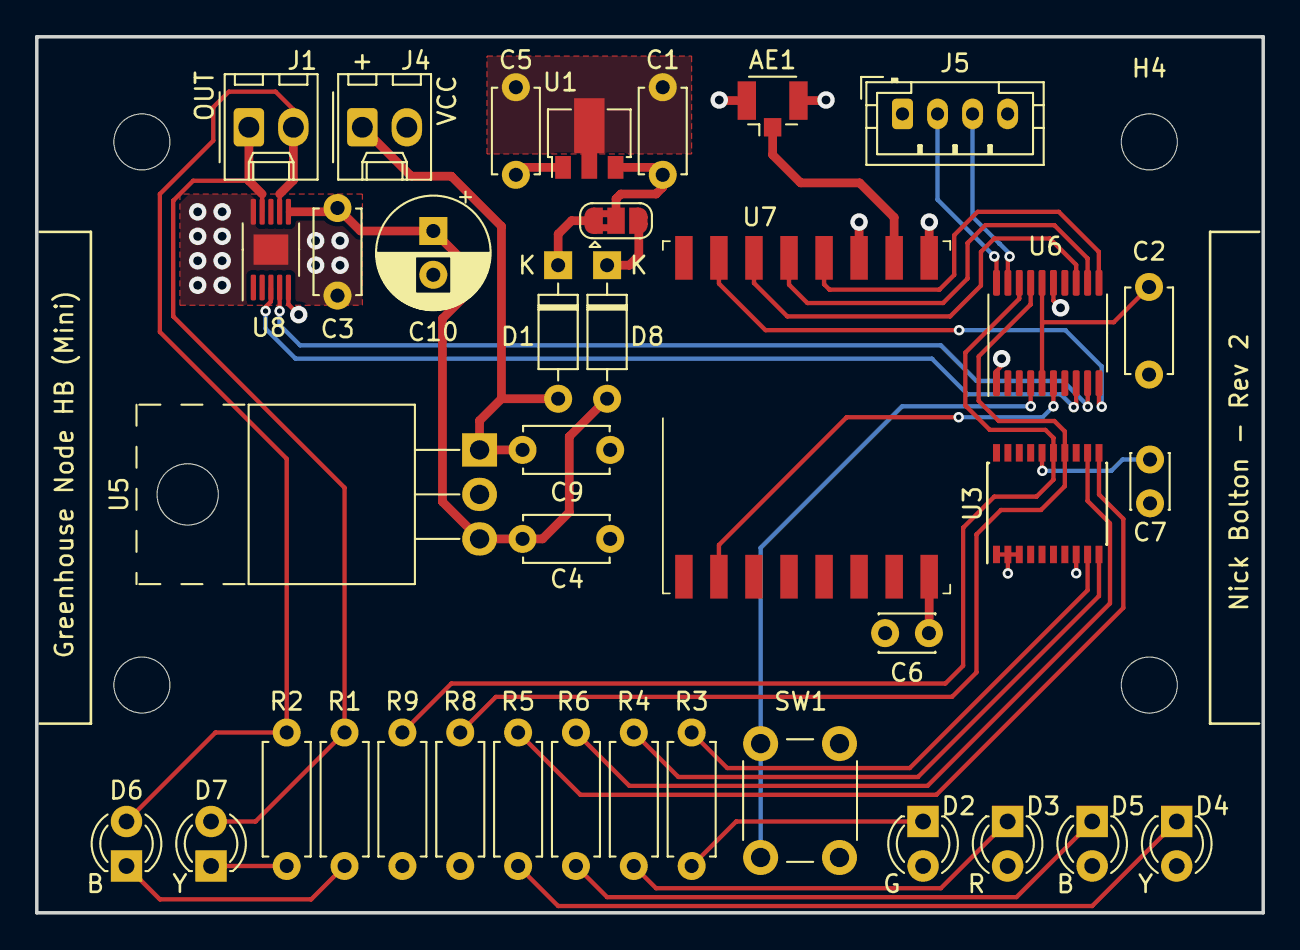
[picture p12: board greenhouse-node-hb.kicad_pcb from above]

Board: 4 copper layers, 70.0 x 50.0 mm, 41 parts (0 on the bottom side), 32 nets.
