nbolton/greenhouse/hardware/greenhouse-battery-junction/greenhouse-battery-junction.kicad_pcb

## KiCad design hardware/greenhouse-battery-junction/greenhouse-battery-junction.kicad_pcb (2022-03-22)

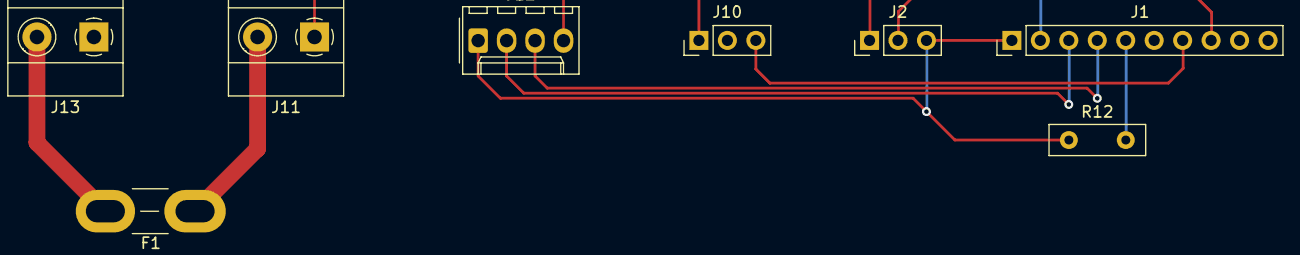
[picture p13: board greenhouse-battery-junction.kicad_pcb from above]

Board: 2 copper layers, 8 parts (0 on the bottom side), 9 nets.

Parts:
F1: Fuse; Fuse_Blade_Mini_directSolder
J1: Conn_01x10_Female; PinHeader_1x10_P2.54mm_Vertical
J2, J10: Conn_01x03_Female; PinHeader_1x03_P2.54mm_Vertical
J11, J13: Screw_Terminal_01x02; TerminalBlock_Phoenix_MKDS-1,5-2-5.08_1x02_P5.08mm_Horizont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
J12: Conn_01x04_Male; Molex_KK-254_AE-6410-04A_1x04_P2.54mm_Vertical
R12: R; R_Box_L8.4mm_W2.5mm_P5.08mm

Connections:
+5V: J1.1, J2.3, J12.1, R12.1
/ADC_A0: J1.7, J10.3
/ADC_A1: J1.8, J2.2
/ADC_ADDR: J1.5, R12.2
/ADC_SCL: J1.3, J12.2
/ADC_SDA: J1.4, J12.3
/BusBar+12V: F1.1, J11.2
/Current_In: F1.2, J13.2
GND: J1.2, J2.1, J10.1, J11.1, J12.4
