nbolton/greenhouse/firmware/greenhouse-node/src/pins.h

#pragma once

#include "attiny.h"

#define PIN_TX_EN PIN_PA0
#define PIN_TX PIN_PA1
#define PIN_RX PIN_PA2
#define PIN_ONE_WIRE PIN_PA3
#define PIN_SR_LATCH PIN_PA4  // RCLK (12)
#define PIN_SR_CLOCK PIN_PA5  // SRCLK (11)
#define PIN_SR_DATA PIN_PA6   // SER (14)
#define PIN_SR_OE PIN_PA7     // OE (13)
#define PIN_MOTOR_PWM PIN_PB2
