nbolton/greenhouse/firmware/greenhouse-node-test/src/pins.h

#define PIN_SR_LATCH D5  // RCLK (12)
#define PIN_SR_DATA D6   // SER (14)
#define PIN_SR_CLOCK D7  // SRCLK (11)
#define PIN_TX_EN 0
#define PIN_TX D1
#define PIN_RX D2
