nbolton/greenhouse/firmware/greenhouse-cu-test/src/common.cpp

#include "common.h"

// float version of Arduino map()
float mapFloat(float v, float inMin, float inMax, float outMin, float outMax)
{
  return (v - inMin) * (outMax - outMin) / (inMax - inMin) + outMin;
}
