nbolton/greenhouse/(commit log)

2021-06-17 Removed bad voltmeter code
2021-06-18 Fixed #5 #7 #11 #10
    [Greenhouse.ino]
2021-06-18 Fixed broken window open logic and add refresh after commands
    [Greenhouse.ino]
2021-06-19 Move Arduino IDE file to legacy
2021-06-19 Exclude Arduino source from native
2021-06-21 Added flash string trace and moved Blynk to single class
    Blynk doesn't like being used in multiple places
2021-06-21 Add newline after trace
2021-06-21 Fixed floats printed as ints
2021-06-21 Removed trace from window/open close logic
    Unit tests make this redundant
2021-06-21 Fixed #12 and fixed missing trace
2021-06-21 Made DHT fail trace code more readable
2021-06-21 Removed default build to switch easier
2021-06-21 First crack at switching from binary to progress-based window state
2021-06-23 Tidied up Blynk handle log traces
2021-06-23 Fixed typo in trace
2021-06-25 Made pin constants more readable
2021-06-25 Improved pin/module constant names
2021-06-28 Only return false at end on sensor fail
2021-07-04 Fixed analog pin and used map (sort of)
2021-07-11 Calibrated soil moisture code and refactored percent function
2021-08-02 Merged in temp code for PV relay and fan/pump switches
    Also switched to I2C expander and analog mux. Replaced DHT sensors with SHT31 (I2C).
2021-08-09 Switched voltage sensor to ADS1115 and applied clang formatting
2021-08-12 Finished implementing ADC
2021-08-13 Switched moisture sensor pin
2021-08-13 Switched pump pin
2021-08-14 Only wait for serial if trace is on
2021-08-14 Abstracted switch water battery logic
2021-08-17 Move heating update to refresh function
2021-08-18 Turn off all switches on restart
2021-08-21 Fixed magic number (relay callback interval)
2021-08-21 Improved relay interval comment
2021-08-21 Fixed: Water heater runtime not reported
2021-08-22 Disabled LED (annoying flashy light)
2021-08-22 Remove voltage average feature
    Average is redundant due to ADC accuracy
2021-08-22 Ignore sensor warnings until after 1st refresh
2021-08-23 Fixed #157
    Value before was a float printed as an int, which caused following value to be corrupted
2021-08-27 #137 Recalibrated PV onboard voltage
2021-08-27 #137 Recalibrated moisture sensor
2021-09-03 Log case fan on/off
2021-09-03 Log onboard PV voltage
2021-09-03 Analog calibration for #176
2021-09-09 Remove useless humidity warning
    There's not much we can realistically/practically do about relative humidity, and as temperature decreases, it's often normal for relative humidity to be 100%.
2021-09-14 Refactor: Split into System and Heating
2021-09-14 Fixed typos for heating (wrong vars used)
2021-09-15 Refactor day/night logic out of Heating
2021-09-16 Moved day/night transition from Heating to System
2021-09-17 More accurate power use for water heater
2021-09-17 Renamed heating cost virtual pin
2021-09-17 Minor variable name change (heating/heater)
2021-09-23 Extracted Power into new class
2021-09-23 Missing changes from extracting Power class
2022-03-21 Replace actuator speed (D8) with SR OE (D0)
2022-03-21 First KiCad schematic and PCB
    [greenhouse-control-unit.kicad_pcb, greenhouse-control-unit.kicad_sch]
2022-03-21 Moved AC relay input to SR
2022-03-21 Add SR TTL, FET labels, tie PSU+12V to +12V
    [greenhouse-control-unit.kicad_pcb]
2022-03-21 Update annotations
    [greenhouse-control-unit.kicad_sch]
2022-03-22 Add photos of prototype
2022-03-22 Add R values, add battery junction schema
    [battery-junction.kicad_sch, greenhouse-control-unit.kicad_sch]
2022-03-22 Add LED on when AC PSU relay NC
    [greenhouse-control-unit.kicad_pcb, greenhouse-control-unit.kicad_sch]
2022-03-22 Add LED on when FET off
    [greenhouse-control-unit.kicad_sch]
2022-03-22 Re-add battery junction schematic
    [greenhouse-control-unit.kicad_sch]
2022-03-22 Add battery junction project
    [battery-junction.kicad_sch, greenhouse-battery-junction.kicad_pcb, greenhouse-battery-junction.kicad_sch, greenhouse-control-unit.kicad_pcb, greenhouse-control-unit.kicad_sch]
2022-03-23 Moved power source LEDs to SR, changed label names
    [greenhouse-control-unit.kicad_pcb, greenhouse-control-unit.kicad_sch]
2022-03-23 Removed flyback diodes (for now)
    [greenhouse-control-unit.kicad_sch]
2022-03-23 Swap U1 and U2 positions on PCB
    [greenhouse-control-unit.kicad_pcb]
2022-03-23 Change PV/PSU switch delay, power source LED code, log format debug,
2022-03-23 Always delay between relay switches
2022-03-23 Rearranged PCB layout, re-annotate power connectors
    [greenhouse-control-unit.kicad_pcb, greenhouse-control-unit.kicad_sch]
2022-03-24 Reduce switch delay, add switch test thread
2022-03-24 Symbol position tweaks
    [greenhouse-control-unit.kicad_sch]
2022-03-24 Add PSU diode, reorganize PCB layout
    [greenhouse-control-unit.kicad_pcb, greenhouse-control-unit.kicad_sch]
2022-03-24 Connect relay coil to VCC, fixed footprints
    [greenhouse-control-unit.kicad_pcb, greenhouse-control-unit.kicad_sch]
2022-03-25 Move actuator to SR
2022-03-26 Fix actuator signal not working, some refactoring
2022-03-26 R values, rearrange SRs on PCB
    [greenhouse-control-unit.kicad_pcb, greenhouse-control-unit.kicad_sch]
2022-03-26 Replaced BJTs with FETs, used horizontal FETs
    [greenhouse-control-unit.kicad_pcb, greenhouse-control-unit.kicad_sch]
2022-03-26 Laid out PCB around new FET layout
    [greenhouse-control-unit.kicad_pcb, greenhouse-control-unit.kicad_sch]
2022-03-27 Caps to SR VCC, tie SRCLR to GND
    [greenhouse-control-unit.kicad_sch]
2022-03-27 Consolidate KK headers, connect all traces on PCB
    [greenhouse-control-unit.kicad_pcb, greenhouse-control-unit.kicad_sch]
2022-03-27 Add mounting holes
    [greenhouse-control-unit.kicad_pcb, greenhouse-control-unit.kicad_sch]
2022-03-27 Tweaked PCB tracks
    [greenhouse-control-unit.kicad_pcb]
2022-03-27 Tweaked PCB tracks (more)
    [greenhouse-control-unit.kicad_pcb]
2022-03-27 Add missing trace for Q9
    [greenhouse-control-unit.kicad_pcb]
2022-03-30 Moved 12V FET tracks to other side
    [greenhouse-control-unit.kicad_pcb]
2022-03-30 Add ground plane
    [greenhouse-control-unit.kicad_pcb]
2022-03-31 SRCLR on SR must be high
    [greenhouse-control-unit.kicad_pcb, greenhouse-control-unit.kicad_sch]
2022-03-31 Use ADC instead of A0 for voltage sensor
2022-04-01 Remove FETs for motor controller; not needed if EN is 5V
    [greenhouse-control-unit.kicad_pcb, greenhouse-control-unit.kicad_sch]
2022-04-01 Updated TODOs
    [greenhouse-control-unit.kicad_sch]
2022-04-01 Updated TODO's to use 2N7x's properly
    [greenhouse-control-unit.kicad_sch]
2022-04-02 Turn case fan on by default
2022-04-08 Add missing F to Log().Trace in embedded
2022-04-08 Add permanent last virtual pin
2022-04-10 Return -1 when unknown voltage (instead of -1 mapped)
2022-04-10 Enable heating by default to fix unit tests
2022-04-11 Update TODO and ignore file
    [greenhouse-control-unit.kicad_sch]
2022-04-14 Removed used of threads to fix #254
2022-04-15 Add loop delay to save power
2022-04-17 Fixed #259
    Also moved power loop to system loop (instead of refresh)
2022-04-17 Implemented actual queue for toggle switch
2022-04-24 Fixed errors in battery junction
    Didn't match up with prototype
    [greenhouse-battery-junction.kicad_sch]
2022-04-24 Ignore KiCad backup files
2022-04-24 New schematic for L298N motor driver
    [L298N-motor-driver.kicad_sch, greenhouse-control-unit.kicad_pcb, greenhouse-control-unit.kicad_sch]
2022-04-24 Changed buzzer FET back to BJT
    [greenhouse-control-unit.kicad_pcb, greenhouse-control-unit.kicad_sch]
2022-04-24 Updated TODO
    [greenhouse-control-unit.kicad_sch]
2022-04-25 Add voltage regulator to motor driver
    [L298N-motor-driver.kicad_sch, greenhouse-control-unit.kicad_pcb, greenhouse-control-unit.kicad_sch]
2022-04-26 Increase relay switch delay
    May help #267
2022-04-26 Swapped actuator pins (circuit changed)
2022-04-26 Improvements for #274
    - Add delay reason (to understand why when we're calling delay)
    - Disable SR by default, enable when there is min common voltage
    - Added more functionality to the SR test code
2022-04-26 Re-introduce initial shift (for beep, fan, etc)
2022-04-26 Change cap for motor driver regulator
    Also moved battery coil to PSU #236
    [L298N-motor-driver.kicad_sch, greenhouse-control-unit.kicad_pcb, greenhouse-control-unit.kicad_sch]
2022-04-27 Replaced free function callbacks with members functions
    Also:
    - prevented callbacks from running until after system started
    - removed onboard LED flash for send/receive data
2022-05-06 Add reverse voltage diode and re-draw ground plane
    [L298N-motor-driver.kicad_sch, greenhouse-control-unit.kicad_pcb, greenhouse-control-unit.kicad_sch]
2022-09-10 Add radio RX + TX modules
    [greenhouse-control-unit.kicad_sch]
2022-09-10 Invert D8 SR on/off
    D8 cannot be high at boot; so invert the SR on/off pin
    [greenhouse-control-unit.kicad_sch]
2022-09-10 Add missing BJT resistor and resize sheet
    [greenhouse-control-unit.kicad_sch]
2022-09-10 Disable radio debug LEDs
2022-09-16 First node schematic
    [greenhouse-node-motor.kicad_sch, greenhouse-node.kicad_pcb, greenhouse-node.kicad_sch]
2022-09-16 Divided dirs into hardware and firmware
    [L298N-motor-driver.kicad_sch, greenhouse-battery-junction.kicad_pcb, greenhouse-battery-junction.kicad_sch, greenhouse-control-unit.kicad_pcb, greenhouse-control-unit.kicad_sch, greenhouse-node-motor.kicad_sch, greenhouse-node.kicad_pcb, greenhouse-node.kicad_sch]
2022-09-16 Redesigned H-bridge
    [greenhouse-node-motor.kicad_sch, greenhouse-node.kicad_sch]
2022-09-16 First PCB design for node
    [greenhouse-node-motor.kicad_sch, greenhouse-node.kicad_pcb, greenhouse-node.kicad_sch]
2022-09-17 Redesign node PCB around mounting holes
    [greenhouse-node-motor.kicad_sch, greenhouse-node.kicad_pcb, greenhouse-node.kicad_sch]
2022-09-17 Changed power BJT for FET
    [greenhouse-node-motor.kicad_sch, greenhouse-node.kicad_pcb, greenhouse-node.kicad_sch]
2022-09-18 Reduced NPN count
    [greenhouse-node.kicad_pcb, greenhouse-node.kicad_sch]
2022-09-18 Finished tracks
    [greenhouse-node.kicad_pcb]
2022-09-18 Fixed missing traces
    [greenhouse-node-motor.kicad_sch, greenhouse-node.kicad_pcb, greenhouse-node.kicad_sch]
2022-09-18 Change LEDs to use H-bridge circuit
    Previously using GND
    [greenhouse-node-motor.kicad_sch, greenhouse-node.kicad_pcb, greenhouse-node.kicad_sch]
2022-09-18 Remove voltage regulator
    Provide +10V with buck converter instead; perhaps regulate actuator with PWM to control speed
    [greenhouse-node-motor.kicad_sch, greenhouse-node.kicad_pcb, greenhouse-node.kicad_sch]
2022-09-19 Change pull-ups to 2k
    Required for PWM (which we may not implement), so may not be totally necessary
    [greenhouse-node-motor.kicad_sch, greenhouse-node.kicad_pcb, greenhouse-node.kicad_sch]
2022-09-20 Make H-bridge PWM enabled
    [greenhouse-node-motor.kicad_sch, greenhouse-node.kicad_pcb, greenhouse-node.kicad_sch]
2022-09-21 Move ATtiny fixes to header
    [main.cpp]
2022-09-22 Add pull downs to SR SER+CLK
    [greenhouse-node-motor.kicad_sch, greenhouse-node.kicad_pcb, greenhouse-node.kicad_sch]
2022-09-23 Remove address pins
    [greenhouse-node.kicad_pcb, greenhouse-node.kicad_sch]
2022-09-24 Micro programming connector
    - Connect SRCLR to +5V
    - Move 10V pull-up away from micro
    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
    [greenhouse-node-motor.kicad_sch, greenhouse-node.kicad_pcb, greenhouse-node.kicad_sch]
2022-09-25 Swap OE and RCLK
    Drive OE low
    Fixed missing SRCLR pull-up
    [greenhouse-node-motor.kicad_sch, greenhouse-node.kicad_pcb, greenhouse-node.kicad_sch]
2022-09-25 Tweak net positions
    [greenhouse-node.kicad_pcb]
2022-09-25 Removed some vias
    [greenhouse-node.kicad_pcb]
2022-09-25 Shorten trace
    [greenhouse-node.kicad_pcb]
2022-09-26 Motor support
2022-09-26 Add cap and diode
    [greenhouse-node-motor.kicad_sch, greenhouse-node.kicad_pcb, greenhouse-node.kicad_sch]
2022-09-26 Reposition RX/TX
    [greenhouse-node.kicad_pcb]
2022-09-27 Add crystal to node board
    [greenhouse-node.kicad_pcb, greenhouse-node.kicad_sch]
2022-09-27 Add value to PCB
    [greenhouse-node-motor.kicad_sch, greenhouse-node.kicad_pcb, greenhouse-node.kicad_sch]
2022-09-27 Repositioned DIPs
    [greenhouse-node.kicad_pcb, greenhouse-node.kicad_sch]
2022-09-27 Tweaking traces
    [greenhouse-node.kicad_pcb]
2022-09-27 Widen crystal traces
    [greenhouse-node.kicad_pcb]
2022-09-27 Improved ground return
    [greenhouse-node.kicad_pcb]
2022-09-28 Fixed: infinite hello loop
    [main.cpp]
2022-09-28 Only check for dupe on motor cmd
2022-09-28 Motor speed control
    With refactoring
2022-09-28 Fixed: Temp req always gets dev 0
    [main.cpp]
2022-09-29 Don't record no temps as error
    [main.cpp]
2022-09-29 Remove small buck
    - Change source to 10V
    - Use 5V for radios
    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
    [L298N-motor-driver.kicad_sch, greenhouse-control-unit.kicad_sch]
2022-09-29 Adjust min power to 0.5V below expected
2022-09-30 Reconfigured SR OE
    - merged motor driver back into main schematic (to avoid needing global labels)
    - renamed labels for headers/sockets
    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
    [L298N-motor-driver.kicad_sch, greenhouse-control-unit.kicad_pcb, greenhouse-control-unit.kicad_sch]
2022-09-30 Cleanup TODOs
    [greenhouse-control-unit.kicad_sch]
2022-09-30 Macro to turn off ADC logging
2022-09-30 Removed PSU separation + voltage sensor
    [greenhouse-control-unit.kicad_sch]
2022-10-02 Fixed: Raw sensor value was used instead of voltage
2022-10-02 Major refactor for battery/PV
    - Renamed PV to battery
    - Removed PSU sensor
    - Adjusted voltage sensor calibration
2022-10-02 Add TODO and changed label name
    [greenhouse-control-unit.kicad_pcb, greenhouse-control-unit.kicad_sch]
2022-10-03 Restore SR OE (non-inverted)
    - Swapped D5/D8; D5 for SR OE which can stay HIGH through reset (except for minor 5ms dip).
    - Pull OE to +3V3 instead of +5V to protect MCU GPIO.
    - Power SR from VU (+5V USB) so we can test SR without main power.
    [greenhouse-control-unit.kicad_sch]
2022-10-03 Mute radio trace messages
2022-10-03 Refactor var names in Power class
2022-10-03 Fix typo in trace
2022-10-03 Implement radio temp sensor
2022-10-03 Refactor printBuffer to use TRACE_C
2022-10-04 Refactored battery/PSU switching
2022-10-06 Check motor state before running
2022-10-06 Add node mini
    [greenhouse-node-mini.kicad_pcb, greenhouse-node-mini.kicad_sch]
2022-10-07 Rearranged resistors
    [greenhouse-node-mini.kicad_pcb]
2022-10-18 Swapped GND/PWR for IC programming connector
    [greenhouse-node-mini.kicad_pcb, greenhouse-node-mini.kicad_sch, greenhouse-node.kicad_pcb, greenhouse-node.kicad_sch]
2022-10-18 Tweak traces
    [greenhouse-node-mini.kicad_pcb]
2022-10-18 Make crystal traces wider
    [greenhouse-node-mini.kicad_pcb]
2022-10-19 Set IO address to 0x20/0x65/0x64
    According to internet, 0x20
    According to datasheet, 0x65/0x64
    [greenhouse-node-mini.kicad_pcb, greenhouse-node-mini.kicad_sch]
2022-10-20 Add I2C pull-ups
    Also reorganised schematic
    [greenhouse-node-mini.kicad_pcb, greenhouse-node-mini.kicad_sch]
2022-10-20 Change LEDs to current sink (PCB WIP)
    [greenhouse-control-unit.kicad_sch, greenhouse-node-mini.kicad_pcb, greenhouse-node-mini.kicad_sch]
2022-10-20 Remove unneccesary pin macros
    Already defined as PIN_PAn
2022-10-20 Use correct pin macros
    [pins.h]
2022-10-22 Reorganised node mini PCB
    [greenhouse-node-mini.kicad_pcb]
2022-10-22 Tweak traces and silkscreen
    [greenhouse-node-mini.kicad_pcb]
2022-10-22 More track tweaking
    [greenhouse-node-mini.kicad_pcb]
2022-10-22 Add hidden 10V track for D8+D10
    Not sure if necessary
    [greenhouse-node-mini.kicad_pcb]
2022-10-22 Cleanup tracks
    [greenhouse-node-mini.kicad_pcb]
2022-10-22 Track tweak
    [greenhouse-node-mini.kicad_pcb]
2022-10-23 Change motor test to run on init
2022-10-23 Change diodes to fast recovery
    [greenhouse-node-mini.kicad_sch]
2022-10-23 Run motor test on both
2022-10-23 Change notes on node schematic
    [greenhouse-node-mini.kicad_sch]
2022-10-26 Reorganize schematics
    [greenhouse-node-mini.kicad_sch, greenhouse-node-motor.kicad_sch, greenhouse-node.kicad_sch]
2022-10-26 Replace RX/TX modules with HC-12
    [greenhouse-control-unit.kicad_pcb, greenhouse-control-unit.kicad_sch, greenhouse-node-mini.kicad_pcb, greenhouse-node-mini.kicad_sch, greenhouse-node.kicad_pcb, greenhouse-node.kicad_sch]
2022-10-28 Replace HC12 with RFM95
    [greenhouse-control-unit.kicad_pcb, greenhouse-control-unit.kicad_sch]
2022-10-28 Remove unnecessary reset
    [greenhouse-control-unit.kicad_sch]
2022-10-29 Replace NodeMCU with Wemos D1
    Also replaced SN74HC595 shift register with PCF8574AN
    [greenhouse-control-unit.kicad_pcb, greenhouse-control-unit.kicad_sch, greenhouse-node.kicad_sch]
2022-10-29 Reduce PCB size
    [greenhouse-control-unit.kicad_pcb, greenhouse-control-unit.kicad_sch]
2022-10-29 Replace relay with sink FET
    [greenhouse-control-unit.kicad_sch]
2022-10-29 Optimized +10V connections
    [greenhouse-control-unit.kicad_pcb, greenhouse-control-unit.kicad_sch]
2022-10-29 Create +10V fill area
    [greenhouse-control-unit.kicad_pcb]
2022-10-29 +10V fill solid pads
    [greenhouse-control-unit.kicad_pcb]
2022-10-29 Tweak 10V resistor positions
    [greenhouse-control-unit.kicad_pcb]
2022-10-29 Fix pull up resistor positions
    [greenhouse-control-unit.kicad_pcb]
2022-10-30 Connected traces on PCB
    [greenhouse-control-unit.kicad_pcb, greenhouse-control-unit.kicad_sch]
2022-10-30 Rev to 2
    [greenhouse-control-unit.kicad_pcb]
2022-10-30 Update date and rev
    [greenhouse-control-unit.kicad_pcb, greenhouse-control-unit.kicad_sch]
2022-10-30 Change beep BJT to sink
    [greenhouse-control-unit.kicad_pcb, greenhouse-control-unit.kicad_sch]
2022-10-30 Reorganised resistors
    [greenhouse-control-unit.kicad_pcb, greenhouse-control-unit.kicad_sch]
2022-10-30 Tweak tracks
    [greenhouse-control-unit.kicad_pcb]
2022-10-30 Replaced purpose labels
    [greenhouse-control-unit.kicad_pcb]
2022-10-30 Flip buzzer
    [greenhouse-control-unit.kicad_pcb]
2022-10-31 Reverse connectors
    Now correct way
    [greenhouse-control-unit.kicad_pcb, greenhouse-control-unit.kicad_sch]
2022-10-31 Rotate LEDs
    [greenhouse-control-unit.kicad_pcb]
2022-10-31 Tidy up plane islands
    [greenhouse-control-unit.kicad_pcb, greenhouse-control-unit.kicad_sch]
2022-10-31 Adjust labels
    [greenhouse-control-unit.kicad_pcb]
2022-10-31 Reposition 10V resistors
    [greenhouse-control-unit.kicad_pcb]
2022-10-31 Fixed ground plane island
    [greenhouse-control-unit.kicad_pcb]
2022-11-01 Simplify motor test
2022-11-01 Changed track
    [greenhouse-control-unit.kicad_pcb]
2022-11-01 Changed to 4 layer board
    [greenhouse-control-unit.kicad_pcb, greenhouse-control-unit.kicad_sch]
2022-11-02 Remove LEDs from PSU/batt d/c
    Sharing IO pin causing gate/base to be pulled high and/or LED to be partially on
    [greenhouse-control-unit.kicad_pcb, greenhouse-control-unit.kicad_sch]
2022-11-04 Add a bunch of BJTs
    [greenhouse-control-unit.kicad_pcb, greenhouse-control-unit.kicad_sch]
2022-11-07 Overhauled transistors
    PSU, battery, beep, fan
    [greenhouse-control-unit.kicad_pcb, greenhouse-control-unit.kicad_sch]
2022-11-08 Swapped ESP8266 for ESP32
    [greenhouse-control-unit.kicad_pcb, greenhouse-control-unit.kicad_sch]
2022-11-09 Moved voltage drop to nodes
    [greenhouse-control-unit.kicad_sch, greenhouse-node-mini.kicad_pcb, greenhouse-node-mini.kicad_sch, greenhouse-node.kicad_pcb, greenhouse-node.kicad_sch]
2022-11-09 Implement HC-12 on node
    Also removed switch logic and old shift register
    [greenhouse-node.kicad_pcb, greenhouse-node.kicad_sch]
2022-11-09 Add missing HC12 conn
    [greenhouse-node.kicad_sch]
2022-11-09 Use onboard MCU ADC
2022-11-09 Joined some tracks
    [greenhouse-node.kicad_pcb]
2022-11-09 Improve external ADC read/retry
2022-11-11 Start TX timer earlier
2022-11-12 Reintroduced battery relay
    [greenhouse-control-unit.kicad_sch]
2022-11-12 Battery relay missing changes
    [greenhouse-control-unit.kicad_pcb]
2022-11-12 Add motor retry (not working)
2022-11-15 Remove motor retry code
2022-11-16 Change buck cons to male
    [greenhouse-control-unit.kicad_sch]
2022-11-16 Fixed DRC errors
    Unconnected pins
    [greenhouse-control-unit.kicad_sch]
2022-11-16 Tidied up PCB
    Repositioned power connectors
    Resized power layer areas
    Tidied up nets
    [greenhouse-control-unit.kicad_pcb]
2022-11-16 Swapped 5V and 3V3 power planes
    [greenhouse-control-unit.kicad_pcb]
2022-11-16 Export fab files
    [greenhouse-control-unit-B_Cu.gbr, greenhouse-control-unit-B_Mask.gbr, greenhouse-control-unit-B_Paste.gbr, greenhouse-control-unit-B_Silkscreen.gbr, greenhouse-control-unit-Edge_Cuts.gbr, greenhouse-control-unit-F_Cu.gbr, greenhouse-control-unit-F_Mask.gbr, greenhouse-control-unit-F_Paste.gbr]
2022-11-16 Finish traces for node
    [greenhouse-node.kicad_pcb, greenhouse-node.kicad_sch]
2022-11-16 Update schematic/PCB meta
    [greenhouse-control-unit.kicad_sch, greenhouse-node-mini.kicad_pcb, greenhouse-node-mini.kicad_sch]
2022-11-16 Applied values to parts
    [greenhouse-control-unit.kicad_pcb]
2022-11-16 Fixed hole diameters
2022-11-17 Final changes for fab/prod
    [greenhouse-node-mini.kicad_pcb, greenhouse-node-mini.kicad_sch]
2022-11-30 Generate BOMs
    [greenhouse-control-unit.csv, greenhouse-node-mini.csv, greenhouse-node.csv]
2022-11-30 Add missing no-connection flags
    [greenhouse-node-mini.kicad_sch, greenhouse-node.kicad_sch]
2022-11-30 Change N/P-MOS parts
    Also added some no-connects
    [greenhouse-node.csv, greenhouse-node.kicad_pcb, greenhouse-node.kicad_sch]
2022-11-30 Add TODO's for caps
    [greenhouse-node-mini.kicad_sch, greenhouse-node.kicad_sch]
2022-11-30 Increment revs
    [greenhouse-control-unit.kicad_sch, greenhouse-node-mini.kicad_sch, greenhouse-node.kicad_sch]
2022-11-30 Fixed annotation references
    Somehow became different to PCB run
    [greenhouse-control-unit.kicad_pcb, greenhouse-control-unit.kicad_sch]
2022-11-30 Regenerate BOM based on new IDs
    [greenhouse-control-unit.csv]
2022-11-30 Fixed beep pull-up cap value
    [greenhouse-control-unit.kicad_pcb]
2022-11-30 Fixed beep pull-up cap value (pt2)
    [greenhouse-control-unit.kicad_sch]
2022-11-30 Use improved ESP32 footprint
    [greenhouse-control-unit.kicad_pcb]
2022-11-30 Widen RFM95 pin headers by 1mm
    [greenhouse-control-unit.kicad_pcb]
2022-11-30 Increase PCB revs
    [greenhouse-control-unit.kicad_pcb, greenhouse-node-mini.kicad_pcb, greenhouse-node.kicad_pcb]
2022-11-30 Add power in/out silkscreen text
    [greenhouse-control-unit.kicad_pcb, greenhouse-control-unit.kicad_sch, greenhouse-node-mini.kicad_pcb, greenhouse-node.kicad_pcb]
2022-11-30 Add + pin text to PCB
    [greenhouse-control-unit.kicad_pcb, greenhouse-node-mini.kicad_pcb, greenhouse-node.kicad_pcb]
2022-11-30 Fixed missing GND on MCU
    [greenhouse-control-unit.kicad_pcb, greenhouse-control-unit.kicad_sch]
2022-11-30 Add TODO to battery junction
    [greenhouse-battery-junction.kicad_sch]
2022-11-30 Trace ext power sensor
2022-11-30 Move trace define to .ini
2022-12-23 Voltage sensor and light switch
    [greenhouse-battery-junction.kicad_sch]
2022-12-26 Set PCF addr to 0x21
    [greenhouse-battery-junction.kicad_sch]
2022-12-26 Fix FET orientation
    [greenhouse-battery-junction.kicad_sch]
2022-12-26 Power saving when battery d/c
    - Using FET to turn voltage divider off
    - Also added light switch
    [greenhouse-control-unit.kicad_sch]
2022-12-26 Slow down measurement when battery low
2022-12-26 Refactor power data reporting
2022-12-27 Revert "Refactor power data reporting"
    This reverts commit c272fd7d1fae32b7ebeeb27ce414ee6bb113ae40.
2022-12-27 Revert "Slow down measurement when battery low"
    This reverts commit 53b147042cad567f4e089b95a4798279f5aea675.
2022-12-27 Revert "Revert "Slow down measurement when battery low""
    This reverts commit 83bc114b4f1248ce976c3e09e6493d205e123dcd.
2022-12-27 Reduce low battery update to 10s
2023-04-22 Hardware R4 (KiCAD 7) (#310)
    * First pass at R4
    * Optimized power use and moved beeper
    * Separate battery and PV voltage sensors
    * Tweak traces
    * Replace diode with back-to-back FET
    * Add notes to schematic
    * Remove IO switch for voltage sensor
    Also changed ADS range to 2V
    * Improved GND loop for battery ADC
    * Add note to schematic
    * Updated ESP32 footprint
    * Increase weather report timeout
    * Turn on PSU and wait
    Maybe this will allow caps to charge first, which could solve #306
    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
    [greenhouse-battery-junction.kicad_sch, greenhouse-control-unit.csv, greenhouse-control-unit.kicad_pcb, greenhouse-control-unit.kicad_sch]
2023-04-22 Add stock column
    [greenhouse-control-unit.csv]
2023-04-22 Set rev to 4B
    [greenhouse-control-unit.kicad_pcb, greenhouse-control-unit.kicad_sch]
2023-04-26 Update to KiCad 7
    [greenhouse-node.kicad_pcb, greenhouse-node.kicad_sch]
2023-04-26 Change radio and MCU to STM32 + RFM69HW
    [greenhouse-node-mini.kicad_pcb, greenhouse-node-mini.kicad_sch]
2023-04-27 Update PCB for node mini
    [greenhouse-node-mini.kicad_pcb, greenhouse-node-mini.kicad_sch]
2023-04-27 Finish PCB for TS, and renamed boards
    [greenhouse-node-hb.csv, greenhouse-node-hb.kicad_pcb, greenhouse-node-hb.kicad_sch, greenhouse-node-ts.csv, greenhouse-node-ts.kicad_pcb, greenhouse-node-ts.kicad_sch, greenhouse-node.kicad_pcb, greenhouse-node.kicad_sch]
2023-04-27 Tweaks to nodes
    [greenhouse-node-hb.kicad_pcb, greenhouse-node-hb.kicad_sch, greenhouse-node-ts.kicad_sch]
2023-04-27 Fixed cap sizes, generated BOMs
    [greenhouse-node-hb.csv, greenhouse-node-hb.kicad_pcb, greenhouse-node-hb.kicad_sch, greenhouse-node-ts.csv, greenhouse-node-ts.kicad_pcb, greenhouse-node-ts.kicad_sch]
2023-04-27 Updated BOM
    [greenhouse-node-ts.csv]
2023-05-06 Fixed FET parts and cap footprints
    [greenhouse-control-unit.kicad_pcb, greenhouse-control-unit.kicad_sch]
2023-05-06 Pull-up P-FETs to both sources
    [greenhouse-control-unit.kicad_pcb, greenhouse-control-unit.kicad_sch]
2023-05-08 TODO's + Power switch improvement idea
    [greenhouse-control-unit.kicad_pcb, greenhouse-control-unit.kicad_sch]
2023-05-08 Add air sensors and fixed addr conflict
    [greenhouse-control-unit.kicad_pcb, greenhouse-control-unit.kicad_sch]
2023-05-08 Radio, pins, power logic
    Disabled radio, fixed pin assignment, fixed power switch logic
    [greenhouse-control-unit.kicad_sch]
